jankae/electronicload/hardware/mechanical/frontpanel.pdf

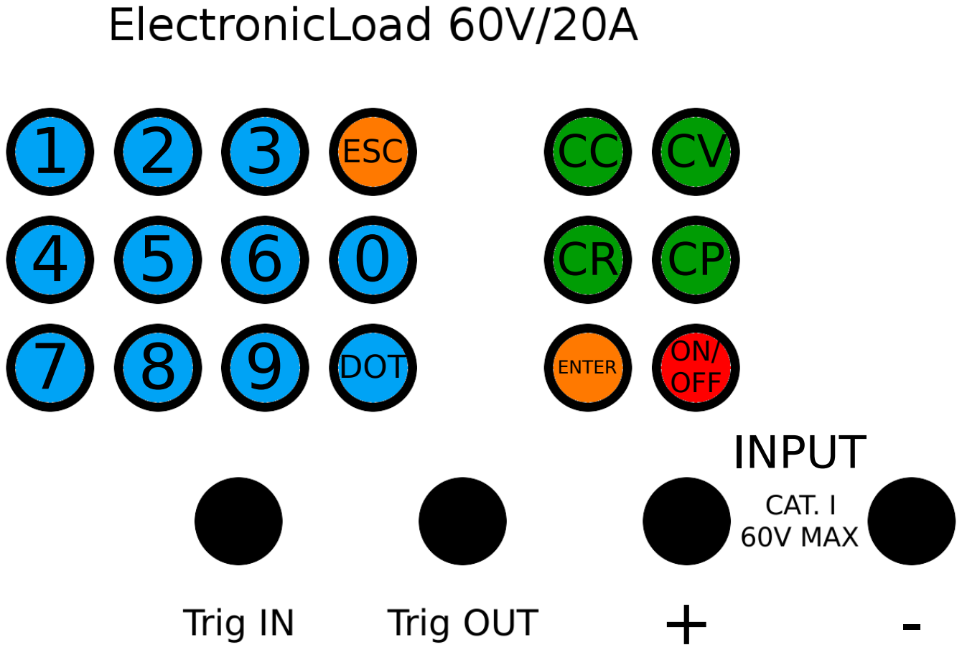
[picture p1: page 1]

ESC

DOT

1 2

ENTER
INPUT

+ -

3
4 5 6
7 8 9

0

CC

ON/
OFF

CV

CR CP
