jankae/electronicload/hardware/pcb/BOM.ods

Value | Description | Link | Price | PowerSupply | AnalogBoard | DigitalBoard | Sum | Available
Pinheader |  | Stiftleiste 1x36 pol gerade | 0.14 € | 4 | 16 | 21 | 41 | 0 | 0.28 €
1000µF/35V | 5mm Grid | RAD FC 1.000/35 (http://www.reichelt.de/Elkos-radial-105-C-1000-5000h/RAD-FC-1-000-35/3/index.html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) | 0.54 € | 2 |  |  | 2 | 0 | 1.08 €
100nF/0603 |  | X7R-G0603 100N (http://www.reichelt.de/Vielschicht-SMD-G0603/X7R-G0603-100N/3/index.html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) | 0.04 € | 6 | 8 | 20 | 34 | 80 | 0
10nF/Y2 | 15mm Grid | MP3-Y2 10N (http://www.reichelt.de/Funkentstoerkondensatoren/MP3-Y2-10N/3/index.html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) | 0.36 € | 2 |  |  | 2 | 0 | 0.72 €
220nF/X2 | 22mm Grid | FUNK 220N (http://www.reichelt.de/Funkentstoerkondensatoren/FUNK-220N/3/index.html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) | 0.21 € | 1 |  |  | 1 | 0 | 0.21 €
2x18V/5VA | Transformer EI42-2 | EI 42/14,8 218 (http://www.reichelt.de/Printtrafos-5-0-8-0VA/EI-42-14-8-218/3/index.html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) | 4.25 € | 1 |  |  | 1 | 0 | 4.25 €
312mA | Fuse+Holder, 22,5mm Grid | PL 112000 (http://www.reichelt.de/Sicherungshalter/PL-112000/3/index.html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) | 0.16 € | 1 |  |  | 1 | 0 | 0.16 €
470µ/16V | 5mm Grid | RAD FC 470/16 (http://www.reichelt.de/Elkos-radial-105-C-1000-5000h/RAD-FC-470-16/3/index.html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) | 0.23 € | 1 |  |  | 1 | 0 | 0.23 €
470µ/35V | 5mm Grid | RAD FC 470/35 (http://www.reichelt.de/Elkos-radial-105-C-1000-5000h/RAD-FC-470-35/3/index.html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) | 0.29 € | 2 |  |  | 2 | 0 | 0.58 €
LM7805 |  | µA 7805 (http://www.reichelt.de/-A-7805/3/index.html?&ACTION=3&LA=446&ARTICLE=23443&artnr=µA+7805&SEARCH=7805) | 0.27 € | 1 |  |  | 1 | 5 | 0
LM7815 |  | µA 7815 (http://www.reichelt.de/-A-7815/3/index.html?&ACTION=3&LA=446&ARTICLE=23458&artnr=µA+7815&SEARCH=7815) | 0.28 € | 1 |  |  | 1 | 0 | 0.28 €
LM7915 |  | µA 7915 (http://www.reichelt.de/-A-7915/3/index.html?&ACTION=3&LA=446&ARTICLE=23496&artnr=µA+7915&SEARCH=7915) | 0.31 € | 1 |  |  | 1 | 0 | 0.31 €
Rectifier | B-Dil | B40C800DIP (http://www.reichelt.de/Gleichrichter/B40C800DIP/3/index.html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) | 0.18 € | 1 |  |  | 1 | 0 | 0.18 €
0R/1206 |  | 1206 SMD 0 Ohm | 0.01 € |  | 1 |  | 1 | 0 | 0.01 €
0R1/5W | 6.4x25mm | 5W AXIAL 0,1 (http://www.reichelt.de/5-Watt-axial/5W-AXIAL-0-1/3/index.html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) | 0.36 € |  | 4 |  | 4 | 0 | 1.44 €
100R/0603 |  |  |  |  | 15 |  | 15 | 50 | 0
100µF/25V | 6mm, 2.5mm Grid | RAD FC 100/25 (http://www.reichelt.de/Elkos-radial-105-C-1000-5000h/RAD-FC-100-25/3/index.html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) | 0.12 € |  | 3 | 2 | 5 | 0 | 0.60 €
10kR/0603 |  |  |  |  | 3 | 2 | 5 | 50 | 0
18kR/0603 |  | 0603 SMD 18k Ohm | 0.01 € |  | 3 |  | 3 | 0 | 0.03 €
1MR/0603 |  | 0603 SMD 1 MOhm | 0.01 € |  | 1 | 1 | 2 | 0 | 0.02 €
1kR/0603 |  |  |  |  |  | 6 | 6 | 30 | 0
1k3R/0603 |  | 0603 SMD 1300 Ohm | 0.01 € |  | 1 |  | 1 | 0 | 0.01 €
22R/0603 |  | 0603 SMD 22 Ohm | 0.01 € |  | 4 | 1 | 5 | 0 | 0.05 €
24kR/0603 |  | 0603 SMD 24k Ohm | 0.01 € |  | 1 |  | 1 | 0 | 0.01 €
2kR/0603 |  | 0603 SMD 2000 Ohm | 0.01 € |  | 3 |  | 3 | 0 | 0.03 €
9k1R/0603 |  | 0603 SMD 9100 Ohm | 0.01 € |  | 1 |  | 1 | 0 | 0.01 €
BSS138 |  | BSS 138SMD (http://www.reichelt.de/BSS-138-SMD/3/index.html?ACTION=3&LA=446&ARTICLE=41437&artnr=BSS+138+SMD&SEARCH=bss138) | 0.04 € |  | 3 |  | 3 | 0 | 0.12 €
DAC7611 |  | DAC 7611U (http://www.reichelt.de/DAC-7611-U/3/index.html?ACTION=3&LA=446&ARTICLE=147248&artnr=DAC+7611+U&SEARCH=dac7611) | 4.30 € |  | 1 |  | 1 | 0 | 4.30 €
INA138 |  | INA138 | 2.49 € |  | 1 |  | 1 | 0 | 2.49 €
IRFP250 |  | IRFP 250N (http://www.reichelt.de/IRFP-250N/3/index.html?ACTION=3&LA=446&ARTICLE=41678&artnr=IRFP+250N&SEARCH=irfp250) | 1.15 € |  | 4 |  | 4 | 0 | 4.60 €
LM35DT |  | LM 35 DT (http://www.reichelt.de/LM-35-DT/3/index.html?ACTION=3&LA=446&ARTICLE=109401&artnr=LM+35+DT&SEARCH=lm35dt) | 1.90 € |  | 2 |  | 2 | 0 | 3.80 €
SHUNT | 2mm Copperwire |  |  |  | 1 |  | 1 | 0 | 0
TL074D |  | TL 074 CD SMD (http://www.reichelt.de/TL-074-CD-SMD/3/index.html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) | 0.32 € |  | 2 |  | 2 | 0 | 0.64 €
TVS-82V | TVS-Diode, CB429-15 | 1,5KE 82A (http://www.reichelt.de/Ueberspannungs-schutzdioden/1-5KE-82A/3/index.html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) | 0.11 € |  | 1 |  | 1 | 0 | 0.11 €
ZD4V7 | Z-Diode, SOT23 | SMD ZD 4,7 (http://www.reichelt.de/SMD-Z-Dioden-SOT23/SMD-ZD-4-7/3/index.html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) | 0.04 € |  | 2 |  | 2 | 0 | 0.08 €
SMD-Switch |  | TASTER 9320 (http://www.reichelt.de/Kurzhubtaster/TASTER-9320/3/index.html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) | 0.21 € |  |  | 18 | 18 | 0 | 3.78 €
LM1117-3.3 |  | TS 1117 BCW33 (http://www.reichelt.de/TS-1117-BCW33/3/index.html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) | 0.30 € |  |  | 1 | 1 | 0 | 0.30 €
ML20 | 20-Pin Connector | Wannenstecker 20 pol ger. | 0.13 € |  |  | 1 | 1 | 0 | 0.13 €
10µH/0805 |  | Indukt. 0805 10µH | 0.24 € |  |  | 1 | 1 | 0 | 0.24 €
16MHz | Crystal, CTS406 | 16,000000-MJ (http://www.reichelt.de/Quarze-SMD-Keramikgehaeuse/16-000000-MJ/3/index.html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) | 0.95 € |  |  | 1 | 1 | 0 | 0.95 €
12pF/0603 |  | 0603 KerKo 12pF | 0.01 € |  |  | 2 | 2 | 0 | 0.02 €
74HC4050D |  | SMD HC 4050 (http://www.reichelt.de/SMD-HC-4050/3/index.html?ACTION=3&LA=446&ARTICLE=18686&artnr=SMD+HC+4050&SEARCH=hc4050) | 0.26 € |  |  | 1 | 1 | 0 | 0.26 €
1N4148 | SOD323 | 1N 4148WS (http://www.reichelt.de/1N-4148-WS/3/index.html?ACTION=3&LA=446&ARTICLE=95197&artnr=1N+4148+WS&SEARCH=1n4148) | 0.04 € |  |  | 18 | 18 | 0 | 0.72 €
5kR | Trimmer | 64W-5,0K (http://www.reichelt.de/Praezisionstrimmer/64W-5-0K/3/index.html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) | 0.32 € |  |  | 1 | 1 | 0 | 0.32 €
1kR | Trimmer | 64W-1,0K (http://www.reichelt.de/Praezisionstrimmer/64W-1-0K/3/index.html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) | 0.32 € |  |  | 1 | 1 | 0 | 0.32 €
74HCT245DW |  | 74VHCT 245 D (http://www.reichelt.de/74VHCT-245-D/3/index.html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) | 0.36 € |  |  | 2 | 2 | 0 | 0.72 €
Encoder+Switch |  |  |  |  |  | 1 | 1 | 1 | 0
IRLML2502 |  | IRLML 2502 (http://www.reichelt.de/IRLML-2502/3/index.html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) | 0.19 € |  |  | 2 | 2 | 0 | 0.38 €
MAX3232CSE |  | MAX 3232CSE (http://www.reichelt.de/MAX-3232-CSE/3/index.html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) | 1.20 € |  |  | 1 | 1 | 0 | 1.20 €
STM32F103RBT6 |  | STM32 F103RBT6 (http://www.reichelt.de/STM32-F103RBT6/3/index.html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) | 4.70 € |  |  | 1 | 1 | 0 | 4.70 €
Display |  | LCD-Modul TG12864B-03 (http://www.pollin.de/shop/dt/NTc1OTc4OTk-/Bauelemente_Bauteile/Aktive_Bauelemente/Displays/LCD_Modul_TG12864B_03.html) | 19.95 € |  |  | 1 | 1 | 0 | 19.95 €
Heatsink1 |  | SK 574 50 (http://www.reichelt.de/Leistungs-Kuehlkoerper/SK-574-50/3/index.html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) | 1.75 € | 1 |  |  | 1 | 0 | 1.75 €
Heatsink2 |  | V 7331G (http://www.reichelt.de/Profilkuehlkoerper/V-7331G/3/index.html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) | 5.99 € |  | 2 |  | 2 | 0 | 11.98 €
GlimmerTO247 |  | GLIMMER SOT 93 (http://www.reichelt.de/Waermeleit-paste-folien-scheiben/GLIMMER-SOT-93/3/index.html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) | 0.05 € |  | 4 |  | 4 | 0 | 0.20 €
GlimmerTO220 |  | GLIMMER TO 220 (http://www.reichelt.de/Waermeleit-paste-folien-scheiben/GLIMMER-TO-220/3/index.html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) | 0.04 € | 3 |  |  | 3 | 0 | 0.12 €
Fan |  | FAN-ML 4010-12 P (http://www.reichelt.de/Luefter/FAN-ML-4010-12-P/3/index.html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) | 1.99 € |  | 2 |  | 2 | 0 | 3.98 €
BNC |  | UG 1094U (http://www.reichelt.de/UG-1094U/3/index.html?ACTION=3&LA=446&ARTICLE=22014&artnr=UG+1094U&SEARCH=bnc) | 0.36 € |  |  | 2 | 2 | 0 | 0.72 €
SUBD |  |  |  |  |  | 1 | 1 | 6 | 0
Polklemme/red |  | PK 4 RT (http://www.reichelt.de/PK-4-RT/3/index.html?ACTION=3&LA=446&ARTICLE=14662&artnr=PK+4+RT&SEARCH=polklemme) | 0.71 € |  | 1 |  | 1 | 0 | 0.71 €
Polklemme/black |  | PK 4 SW (http://www.reichelt.de/PK-4-SW/3/index.html?ACTION=3&LA=446&ARTICLE=14663&artnr=PK+4+SW&SEARCH=polklemme) | 0.71 € |  | 1 |  | 1 | 0 | 0.71 €
 |  |  |  |  |  |  |  |  | 80.79 €
