jankae/electronicload/hardware/pcb/analogControlBoardV1_3.brd

## EAGLE design hardware/pcb/analogControlBoardV1_3.brd (2017-04-25)

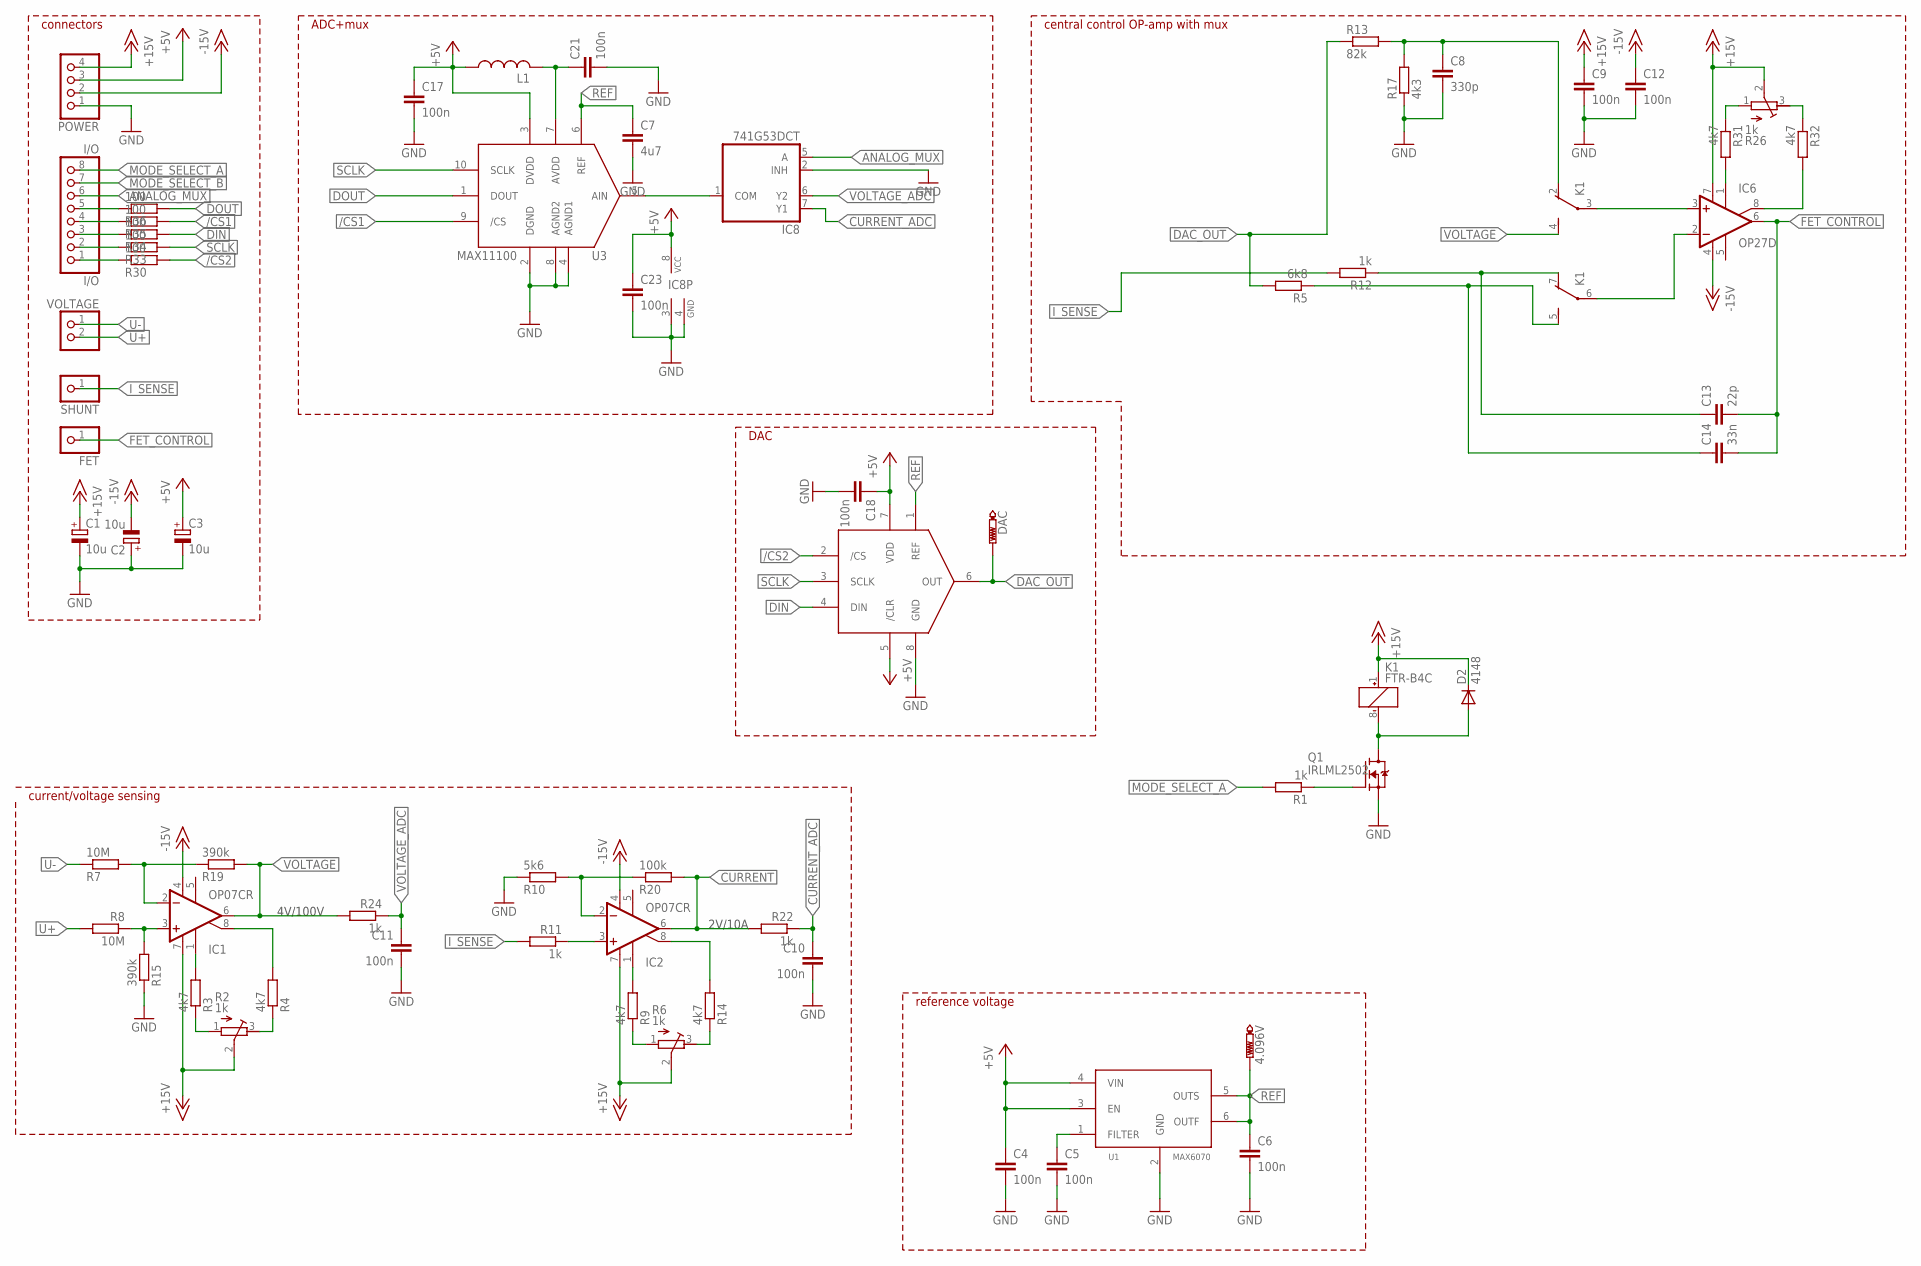
[picture p2: schematic analogControlBoardV1_3.sch]

Parts:
4.096V: PTR1TP14R; TP14R
C1, C2, C3: 10u; 153CLV-0505
C4, C5, C6, C9, C10, C11, C12, C17, C18, C21, C23: 100n; C0603K
C7: 4u7; C0805
C8: 330p; C0603K
C13: 22p; C0603K
C14: 33n; C0603K
D2: 4148; SOD123
DAC: PTR1TP14R; TP14R
FET: PINHD-1X1; 1X01
I/O: I/O; 1X08
IC1, IC2: OP07CR; SO08
IC6: OP27D; SO08
IC8: 741G53DCT; DCT_R-PDSO-G8
K1: FTR-B4C
L1: INDUCTOR0603; R0603
POWER: PINHD-1X4; 1X04
Q1: IRLML2502; SOT23-3
R1, R11, R12, R22, R24: 1k; R0603
R2, R6, R26: 1k; RTRIM64W
R3, R4, R9, R14, R31, R32: 4k7; R0603
R5: 6k8; R0603
R7, R8: 10M; R0603
R10: 5k6; R0603
R13: 82k; R0603
R15, R19: 390k; R0603
R17: 4k3; R0603
R20: 100k; R0603
R30, R33, R34, R35, R36: 100; R0603
SHUNT: PINHD-1X1; 1X01
U1: MAX6070; SOT23-6L
U2: MAX5216; UMAX8
U3: MAX11100; UMAX10
VOLTAGE: PINHD-1X2; 1X02

Connections:
+5V: C3.+, C4.1, C17.1, C18.1, C23.1, IC8.8 (VCC), L1.1, POWER.3, U1.3 (EN), U1.4 (VIN), U2.5 (/CLR), U2.7 (VDD), U3.3 (DVDD)
+15V: C1.+, C9.1, D2.C, IC1.7 (V+), IC2.7 (V+), IC6.7 (V+), K1.1 (+), POWER.4, R2.2 (S), R6.2 (S), R26.2 (S)
-15V: C2.-, C12.1, IC1.4 (V-), IC2.4 (V-), IC6.4 (V-), POWER.2
/CS1: R35.2, U3.9 (/CS)
/CS2: R30.2, U2.2 (/CS)
ANALOG_MUX: I/O.6, IC8.5 (A)
CURRENT: IC2.6 (OUT), R20.2, R22.2
CURRENT_ADC: C10.1, IC8.7 (Y1), R22.1
DAC_OUT: DAC.TP, R5.2, R13.1, U2.6 (OUT)
DIN: R34.2, U2.4 (DIN)
DOUT: R36.2, U3.1 (DOUT)
FET_CONTROL: C13.2, C14.2, FET.1, IC6.6 (OUT)
GND: C1.-, C2.+, C3.-, C4.2, C5.2, C6.2, C7.2, C8.2, C9.2, C10.2, C11.2, C12.2, C17.2, C18.2, C21.2, C23.2, IC8.2 (INH), IC8.3 (GND), IC8.4 (GND), POWER.1, Q1.2 (S), R10.1, R15.1, R17.1, U1.2 (GND), U2.8 (GND), U3.2 (DGND), U3.4 (AGND1), U3.8 (AGND2)
I_SENSE: R11.2, R12.2, SHUNT.1
MODE_SELECT_A: I/O.8, R1.2
MODE_SELECT_B: I/O.7
unnamed: C8.1, K1.2 (O), R13.2, R17.2
unnamed: D2.A, K1.8 (-), Q1.3 (D)
unnamed: Q1.1 (G), R1.1
unnamed: C13.1, K1.7 (O), R12.1
unnamed: IC2.3 (+IN), R11.1
unnamed: IC2.2 (-IN), R10.2, R20.1
unnamed: R2.1 (E), R3.1
unnamed: IC1.8 (ON2), R4.2
unnamed: R26.3 (A), R32.1
unnamed: R2.3 (A), R4.1
unnamed: IC6.1 (ON1), R31.2
unnamed: IC1.1 (ON1), R3.2
unnamed: R6.1 (E), R9.1
unnamed: IC2.8 (ON2), R14.2
unnamed: R6.3 (A), R14.1
unnamed: IC2.1 (ON1), R9.2
unnamed: I/O.5, R36.1
unnamed: I/O.4, R35.1
unnamed: I/O.3, R34.1
unnamed: I/O.2, R33.1
unnamed: I/O.1, R30.1
unnamed: IC6.3 (+IN), K1.3
unnamed: C5.1, U1.1 (FILTER)
unnamed: IC6.2 (-IN), K1.6
unnamed: C14.1, K1.5 (S), R5.1
unnamed: R26.1 (E), R31.1
unnamed: IC6.8 (ON2), R32.2
unnamed: C21.1, L1.2, U3.7 (AVDD)
unnamed: IC8.1 (COM), U3.5 (AIN)
unnamed: IC1.3 (+IN), R8.1, R15.2
unnamed: IC1.2 (-IN), R7.2, R19.1
REF: 4.096V.TP, C6.1, C7.1, U1.5 (OUTS), U1.6 (OUTF), U2.1 (REF), U3.6 (REF)
SCLK: R33.2, U2.3 (SCLK), U3.10 (SCLK)
U+: R8.2, VOLTAGE.2
U-: R7.1, VOLTAGE.1
VOLTAGE: IC1.6 (OUT), K1.4 (S), R19.2, R24.2
VOLTAGE_ADC: C11.1, IC8.6 (Y2), R24.1

Notes on the sheet:
2V/10A
4V/100V
connectors
ADC+mux
DAC
current/voltage sensing
reference voltage
central control OP-amp with mux

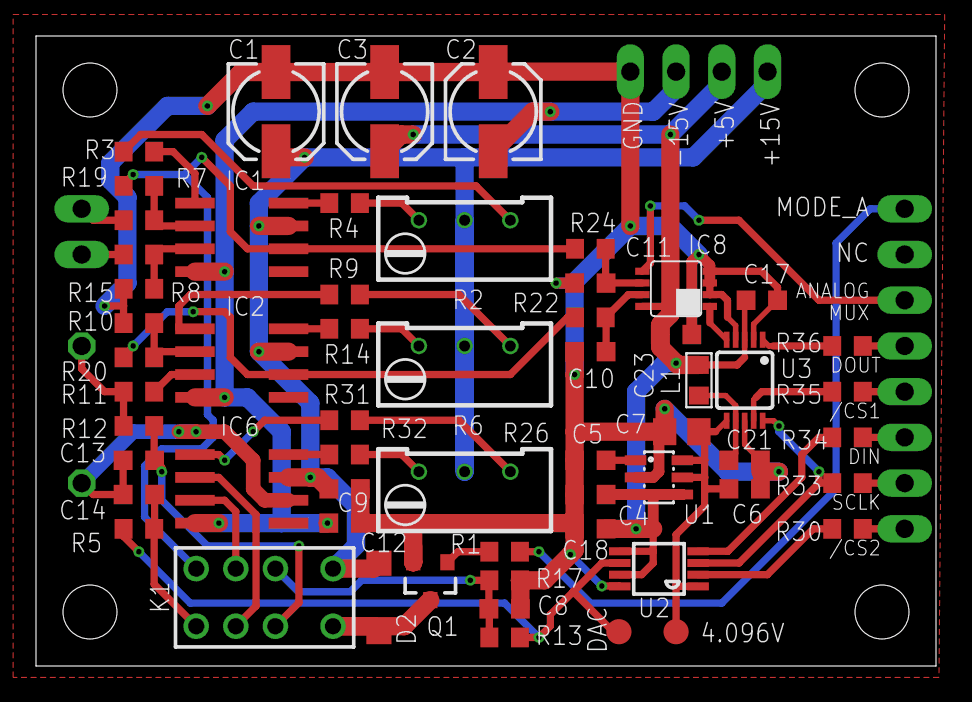
[picture p3: board analogControlBoardV1_3.brd from above]

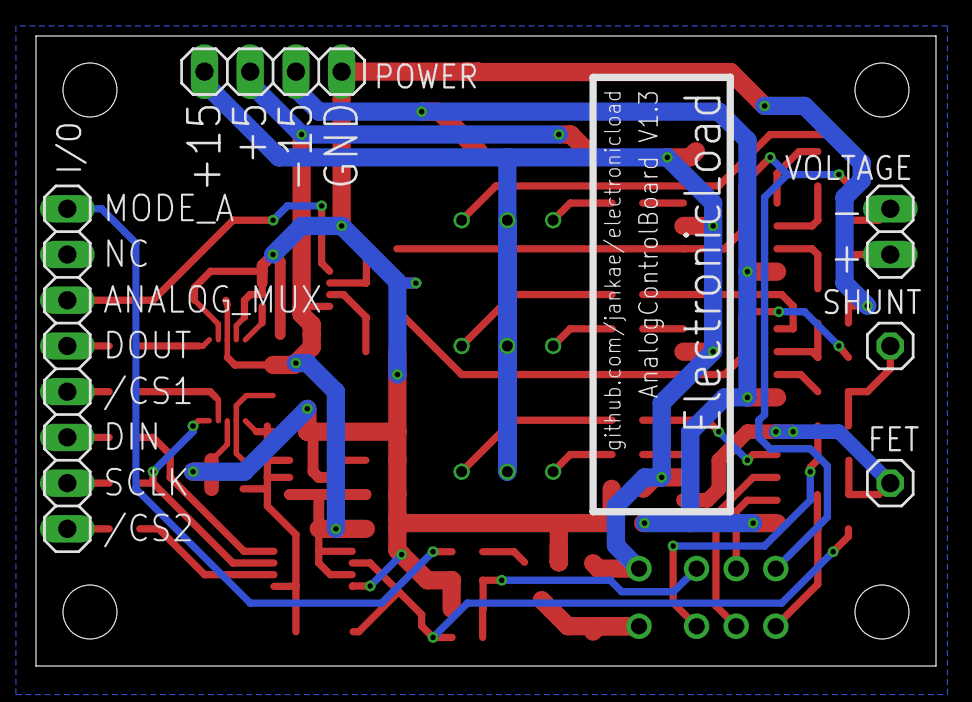
[picture p4: board analogControlBoardV1_3.brd from below]

Board: 2 copper layers, 50.0 x 35.0 mm, 64 parts (5 on the bottom side), 52 nets.
