jankae/electronicload/hardware/pcb/analogBoardV1_5.brd

## EAGLE design hardware/pcb/analogBoardV1_5.brd (2016-09-09)

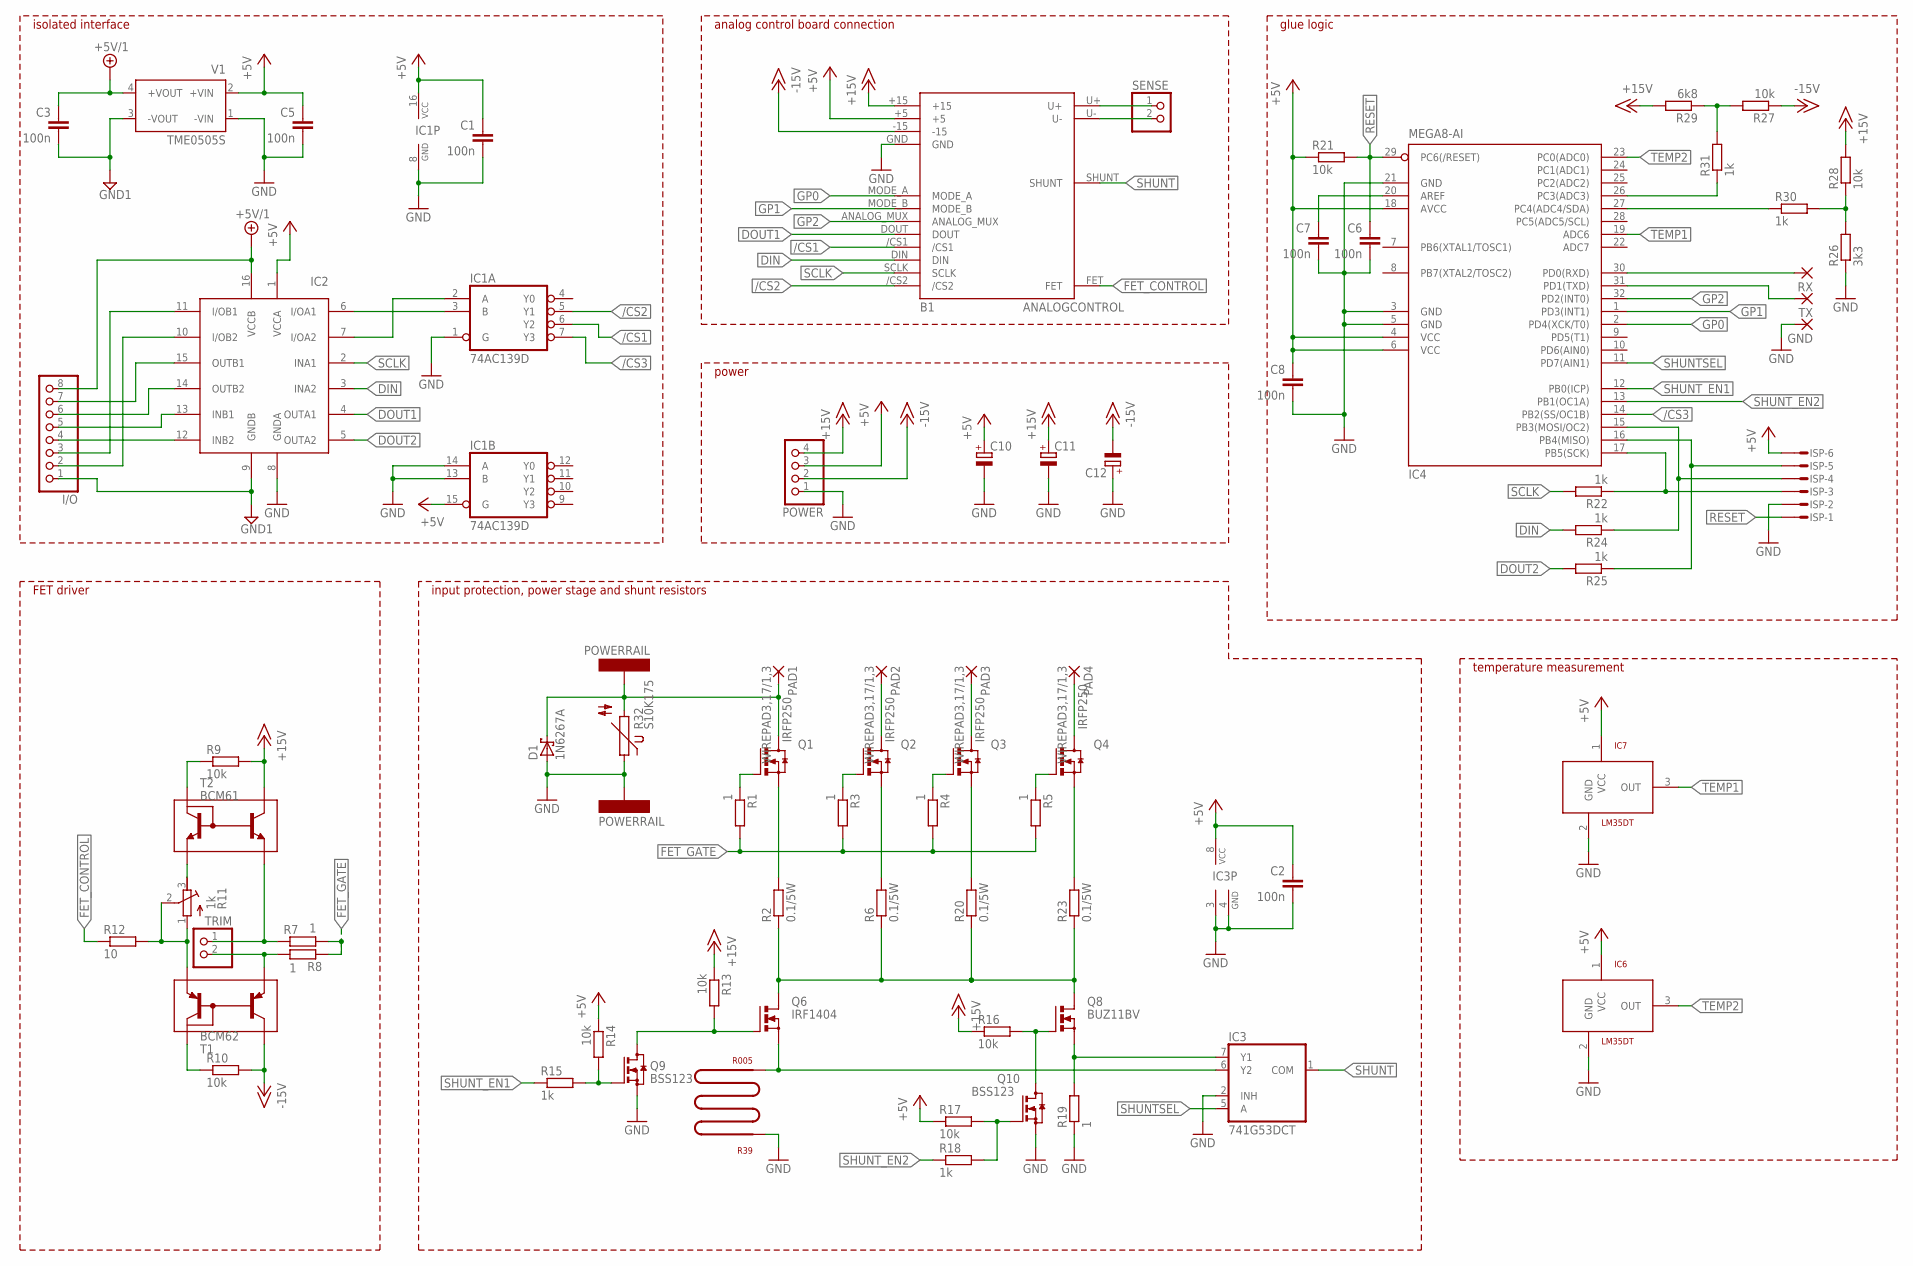
[picture p5: schematic analogBoardV1_5.sch]

Parts:
B1: ANALOGCONTROL
C1, C2, C3, C5, C6, C7, C8: 100n; C0603K
C10, C11, C12: CPOL-EUE2.5-6; E2,5-6
D1: 1N6267A; C4111-15
GND: SMD2; SMD1,27-2,54
I/O: PINHD-1X8; 1X08
IC1: 74AC139D; SO16
IC2: MAX14850; SOIC16N
IC3: 741G53DCT; DCT_R-PDSO-G8
IC4: MEGA8-AI; TQFP32-08
IC6, IC7: LM35DT; TO220V
ISP: MICROMATCH-6SMF; MMT-F-SMD-6
PAD1, PAD2, PAD3, PAD4: WIREPAD3,17/1,3; 3,17/1,3
POWER: PINHD-1X4; 1X04
Q1, Q2, Q3, Q4: IRFP250; TO-247AD-V
Q6: IRF1404; TO220BV
Q8: BUZ11BV; TO220BV
Q9, Q10: BSS123; SOT23
R1, R3, R4, R5, R7, R8: 1; R0603
R2, R6, R20, R23: 0.1/5W; 5WAXIAL_H
R9, R10, R13, R14, R16, R17, R21, R27, R28: 10k; R0603
R11: 1k; RTRIM64W
R12: 10; R0603
R15, R18, R22, R24, R25, R30, R31: 1k; R0603
R19: 1; 0414/15
R26: 3k3; R0603
R29: 6k8; R0603
R32: S10K175
R39: R005; PWR4412-2S
RX: SMD2; SMD1,27-2,54
SENSE: PINHD-1X2; 1X02
T1: BCM62; SOT143B
T2: BCM61; SOT143B
TRIM: PINHD-1X2; 1X02
TX: SMD2; SMD1,27-2,54
U$1, U$2: POWERRAIL
V1: TME0505S; TME

Connections:
+5V: B1.+5, C1.1, C2.1, C5.1, C8.1, C10.+, IC1.15 (G), IC1.16 (VCC), IC2.1 (VCCA), IC3.8 (VCC), IC4.4 (VCC), IC4.6 (VCC), IC4.18 (AVCC), IC6.1 (VCC), IC7.1 (VCC), ISP.6, POWER.3, R14.1, R17.1, R21.1, V1.2 (+VIN)
+5V/1: C3.1, I/O.8, IC2.16 (VCCB), V1.4 (+VOUT)
+15V: B1.+15, C11.+, POWER.4, R9.2, R13.1, R16.1, R28.2, R29.2, T2.2
-15V: B1.-15, C12.-, POWER.2, R10.2, R27.1, T1.2
/CS1: B1./CS1, IC1.6 (Y2)
/CS2: B1./CS2, IC1.5 (Y1)
/CS3: IC1.7 (Y3), IC4.14 (PB2(SS/OC1B))
DIN: B1.DIN, IC2.3 (INA2), R24.2
DOUT1: B1.DOUT, IC2.4 (OUTA1)
DOUT2: IC2.5 (OUTA2), R25.2
FET_CONTROL: B1.FET, R12.1
FET_GATE: R1.2, R3.2, R4.2, R5.2, R7.2, R8.1
GND: B1.GND, C1.2, C2.2, C5.2, C6.2, C7.2, C8.2, C10.-, C11.-, C12.+, D1.A, GND.1, IC1.1 (G), IC1.8 (GND), IC1.13 (B), IC1.14 (A), IC2.8 (GNDA), IC3.2 (INH), IC3.3 (GND), IC3.4 (GND), IC4.3 (GND), IC4.5 (GND), IC4.21 (GND), IC6.2 (GND), IC7.2 (GND), ISP.2, POWER.1, Q9.2 (S), Q10.2 (S), R19.1, R26.1, R32.1, R39.P$1, U$2.1, V1.1 (-VIN)
GND1: C3.2, I/O.1, IC2.9 (GNDB), V1.3 (-VOUT)
GP0: B1.MODE_A, IC4.2 (PD4(XCK/T0))
GP1: B1.MODE_B, IC4.1 (PD3(INT1))
GP2: B1.ANALOG_MUX, IC4.32 (PD2(INT0))
N: Q6.D, Q8.D, R2.1, R6.1, R20.1, R23.1
unnamed: R9.1, T2.1
unnamed: Q1.G, R1.1
unnamed: Q1.S, R2.2
unnamed: Q4.G, R5.1
unnamed: Q3.G, R4.1
unnamed: Q2.G, R3.1
unnamed: I/O.4, IC2.12 (INB2)
unnamed: Q2.S, R6.2
unnamed: R7.1, T2.3, TRIM.1
unnamed: R8.2, T1.3, TRIM.2
unnamed: R10.1, T1.1
unnamed: I/O.5, IC2.13 (INB1)
unnamed: R11.3 (A), T2.4
unnamed: I/O.6, IC2.14 (OUTB2)
unnamed: I/O.7, IC2.15 (OUTB1)
unnamed: B1.U+, SENSE.1
unnamed: Q6.G, Q9.3 (D), R13.2
unnamed: Q3.S, R20.2
unnamed: R11.1 (E), R11.2 (S), R12.2, T1.4
unnamed: IC1.3 (B), IC2.6 (I/OA1)
unnamed: Q9.1 (G), R14.2, R15.2
unnamed: Q8.G, Q10.3 (D), R16.2
unnamed: Q10.1 (G), R17.2, R18.2
unnamed: PAD2.1, Q2.D
unnamed: IC1.2 (A), IC2.7 (I/OA2)
unnamed: Q4.S, R23.2
unnamed: I/O.3, IC2.11 (I/OB1)
unnamed: I/O.2, IC2.10 (I/OB2)
unnamed: PAD3.1, Q3.D
unnamed: C7.1, IC4.20 (AREF)
unnamed: IC4.30 (PD0(RXD)), RX.1
unnamed: IC4.31 (PD1(TXD)), TX.1
unnamed: R26.2, R28.1, R30.2
unnamed: R27.2, R29.1, R31.2
unnamed: IC4.27 (PC4(ADC4/SDA)), R30.1
unnamed: IC4.26 (PC3(ADC3)), R31.1
unnamed: B1.U-, SENSE.2
unnamed: IC4.15 (PB3(MOSI/OC2)), ISP.4, R24.1
unnamed: IC4.17 (PB5(SCK)), ISP.3, R22.1
unnamed: IC4.16 (PB4(MISO)), ISP.5, R25.1
POS_INPUT1: PAD4.1, Q4.D
RESET: C6.1, IC4.29 (PC6(/RESET)), ISP.1, R21.2
SCLK: B1.SCLK, IC2.2 (INA1), R22.2
SHUNT: B1.SHUNT, IC3.1 (COM)
SHUNT1: IC3.6 (Y2), Q6.S, R39.P$2
SHUNT2: IC3.7 (Y1), Q8.S, R19.2
SHUNTSEL: IC3.5 (A), IC4.11 (PD7(AIN1))
SHUNT_EN1: IC4.12 (PB0(ICP)), R15.1
SHUNT_EN2: IC4.13 (PB1(OC1A)), R18.1
TEMP1: IC4.19 (ADC6), IC7.3 (OUT)
TEMP2: IC4.23 (PC0(ADC0)), IC6.3 (OUT)
VIN: D1.C, PAD1.1, Q1.D, R32.2, U$1.1

Notes on the sheet:
FET driver
input protection, power stage and shunt resistors
temperature measurement
power
analog control board connection
glue logic
isolated interface

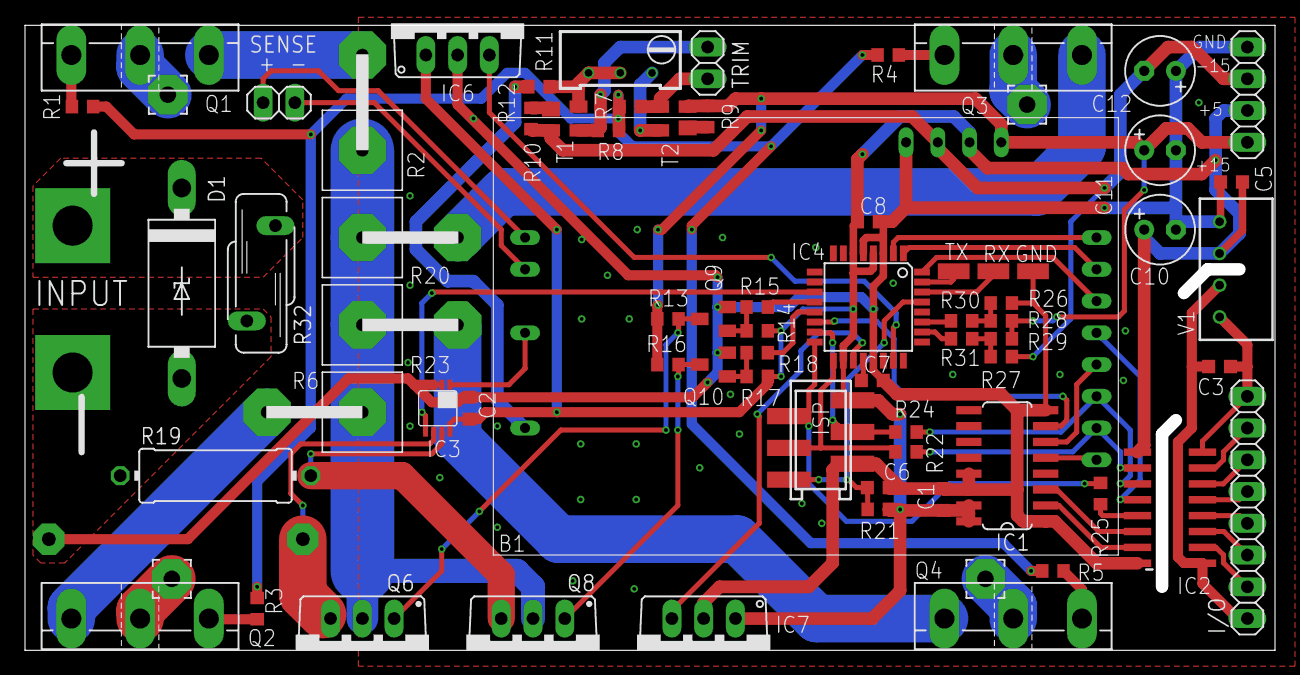
[picture p6: board analogBoardV1_5.brd from above]

Board: 2 copper layers, 100.0 x 50.0 mm, 76 parts (0 on the bottom side), 70 nets.
