jankae/electronicload/hardware/pcb/analogControlBoardV1.brd

## EAGLE design hardware/pcb/analogControlBoardV1.brd (2016-09-09, an earlier design)

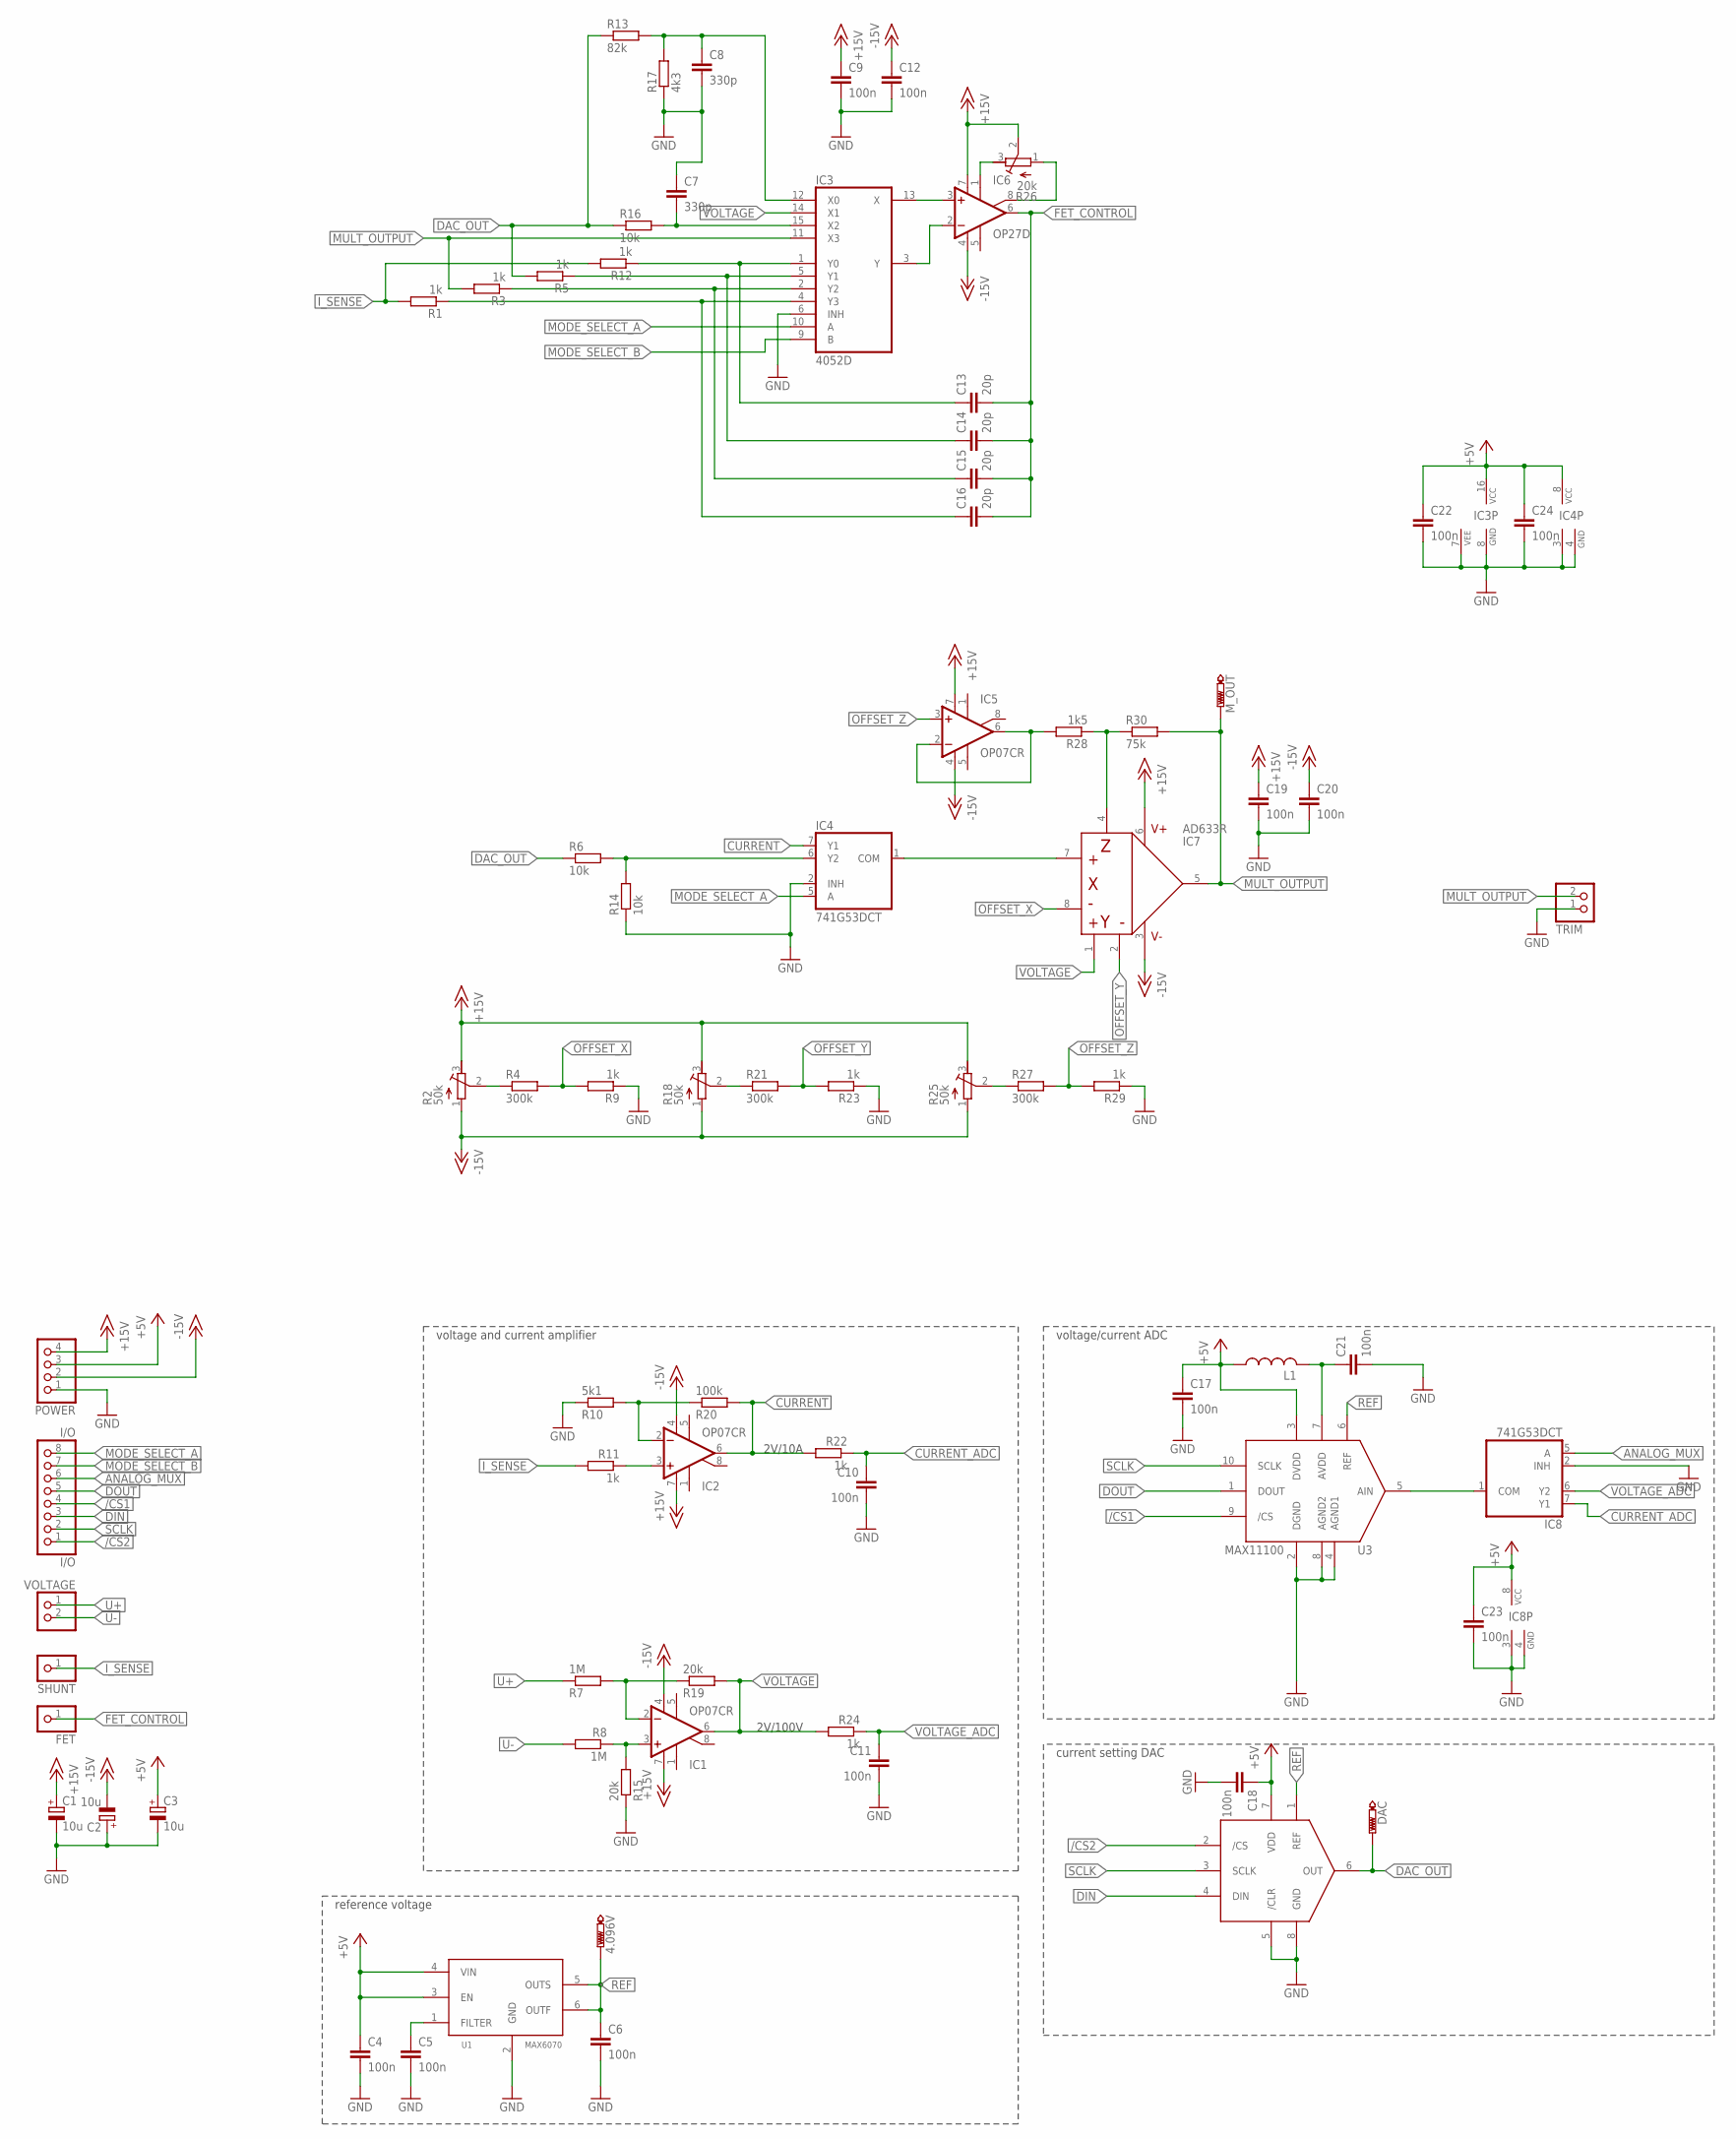
[picture p7: schematic analogControlBoardV1.sch]

Parts:
4.096V: PTR1TP06R; TP06R
C1, C2, C3: 10u; 153CLV-0505
C4, C5, C6, C9, C10, C11, C12, C17, C18, C19, C20, C21, C22, C23, C24: 100n; C0603K
C7, C8: 330p; C0603K
C13, C14, C15, C16: 20p; C0603K
DAC: PTR1TP06R; TP06R
FET: PINHD-1X1; 1X01
I/O: I/O; 1X08
IC1, IC2, IC5: OP07CR; SO08
IC3: 4052D; SO16
IC4, IC8: 741G53DCT; DCT_R-PDSO-G8
IC6: OP27D; SO08
IC7: AD633R; SO08
L1: INDUCTOR0603; R0603
M_OUT: PTR1TP06R; TP06R
POWER: PINHD-1X4; 1X04
R1, R3, R5, R9, R11, R12, R22, R23, R24, R29: 1k; R0603
R2, R18, R25: 50k; RTRIM64W
R4, R21, R27: 300k; R0603
R6, R14, R16: 10k; R0603
R7, R8: 1M; R0603
R10: 5k1; R0603
R13: 82k; R0603
R15, R19: 20k; R0603
R17: 4k3; R0603
R20: 100k; R0603
R26: 20k; RTRIM64W
R28: 1k5; R0603
R30: 75k; R0603
SHUNT: PINHD-1X1; 1X01
TRIM: PINHD-1X2; 1X02
U1: MAX6070; SOT23-6L
U2: MAX5216; UMAX8
U3: MAX11100; UMAX10
VOLTAGE: PINHD-1X2; 1X02

Connections:
+5V: C3.+, C4.1, C17.1, C18.1, C22.1, C23.1, C24.1, IC3.16 (VCC), IC4.8 (VCC), IC8.8 (VCC), L1.1, POWER.3, U1.3 (EN), U1.4 (VIN), U2.7 (VDD), U3.3 (DVDD)
+15V: C1.+, C9.1, C19.1, IC1.7 (V+), IC2.7 (V+), IC5.7 (V+), IC6.7 (V+), IC7.6 (V+), POWER.4, R2.3 (A), R18.3 (A), R25.3 (A), R26.2 (S)
-15V: C2.-, C12.1, C20.1, IC1.4 (V-), IC2.4 (V-), IC5.4 (V-), IC6.4 (V-), IC7.3 (V-), POWER.2, R2.1 (E), R18.1 (E), R25.1 (E)
/CS1: I/O.4, U3.9 (/CS)
/CS2: I/O.1, U2.2 (/CS)
ANALOG_MUX: I/O.6, IC8.5 (A)
CURRENT: IC2.6 (OUT), IC4.7 (Y1), R20.2, R22.2
CURRENT_ADC: C10.1, IC8.7 (Y1), R22.1
DAC_OUT: DAC.TP, R5.2, R6.1, R13.1, R16.1, U2.6 (OUT)
DIN: I/O.3, U2.4 (DIN)
DOUT: I/O.5, U3.1 (DOUT)
FET_CONTROL: C13.2, C14.2, C15.2, C16.2, FET.1, IC6.6 (OUT)
GND: C1.-, C2.+, C3.-, C4.2, C5.2, C6.2, C7.1, C8.2, C9.2, C10.2, C11.2, C12.2, C17.2, C18.2, C19.2, C20.2, C21.2, C22.2, C23.2, C24.2, IC3.6 (INH), IC3.7 (VEE), IC3.8 (GND), IC4.2 (INH), IC4.3 (GND), IC4.4 (GND), IC8.2 (INH), IC8.3 (GND), IC8.4 (GND), POWER.1, R9.1, R10.1, R14.1, R15.1, R17.1, R23.1, R29.1, TRIM.1, U1.2 (GND), U2.5 (/CLR), U2.8 (GND), U3.2 (DGND), U3.4 (AGND1), U3.8 (AGND2)
I_SENSE: R1.2, R11.2, R12.2, SHUNT.1
MODE_SELECT_A: I/O.8, IC3.10 (A), IC4.5 (A)
MODE_SELECT_B: I/O.7, IC3.9 (B)
MULT_OUTPUT: IC3.11 (X3), IC7.5 (OUT), M_OUT.TP, R3.2, R30.2, TRIM.2
unnamed: C8.1, IC3.12 (X0), R13.2, R17.2
unnamed: IC7.4 (Z), R28.1, R30.1
unnamed: IC4.6 (Y2), R6.2, R14.2
unnamed: C13.1, IC3.1 (Y0), R12.1
unnamed: IC2.3 (+IN), R11.1
unnamed: IC2.2 (-IN), R10.2, R20.1
unnamed: IC5.2 (-IN), IC5.6 (OUT), R28.2
unnamed: R25.2 (S), R27.1
unnamed: C7.2, IC3.15 (X2), R16.2
unnamed: IC3.13 (X), IC6.3 (+IN)
unnamed: C5.1, U1.1 (FILTER)
unnamed: IC3.3 (Y), IC6.2 (-IN)
unnamed: IC4.1 (COM), IC7.7 (X+)
unnamed: R18.2 (S), R21.1
unnamed: C16.1, IC3.4 (Y3), R1.1
unnamed: R2.2 (S), R4.1
unnamed: C15.1, IC3.2 (Y2), R3.1
unnamed: C14.1, IC3.5 (Y1), R5.1
unnamed: IC6.1 (ON1), R26.3 (A)
unnamed: IC6.8 (ON2), R26.1 (E)
unnamed: C21.1, L1.2, U3.7 (AVDD)
unnamed: IC8.1 (COM), U3.5 (AIN)
unnamed: IC1.3 (+IN), R8.1, R15.2
unnamed: IC1.2 (-IN), R7.2, R19.1
OFFSET_X: IC7.8 (X-), R4.2, R9.2
OFFSET_Y: IC7.2 (Y-), R21.2, R23.2
OFFSET_Z: IC5.3 (+IN), R27.2, R29.2
REF: 4.096V.TP, C6.1, U1.5 (OUTS), U1.6 (OUTF), U2.1 (REF), U3.6 (REF)
SCLK: I/O.2, U2.3 (SCLK), U3.10 (SCLK)
U+: R7.1, VOLTAGE.1
U-: R8.2, VOLTAGE.2
VOLTAGE: IC1.6 (OUT), IC3.14 (X1), IC7.1 (Y+), R19.2, R24.2
VOLTAGE_ADC: C11.1, IC8.6 (Y2), R24.1

Notes on the sheet:
2V/10A
2V/100V
reference voltage
voltage and current amplifier
voltage/current ADC
current setting DAC

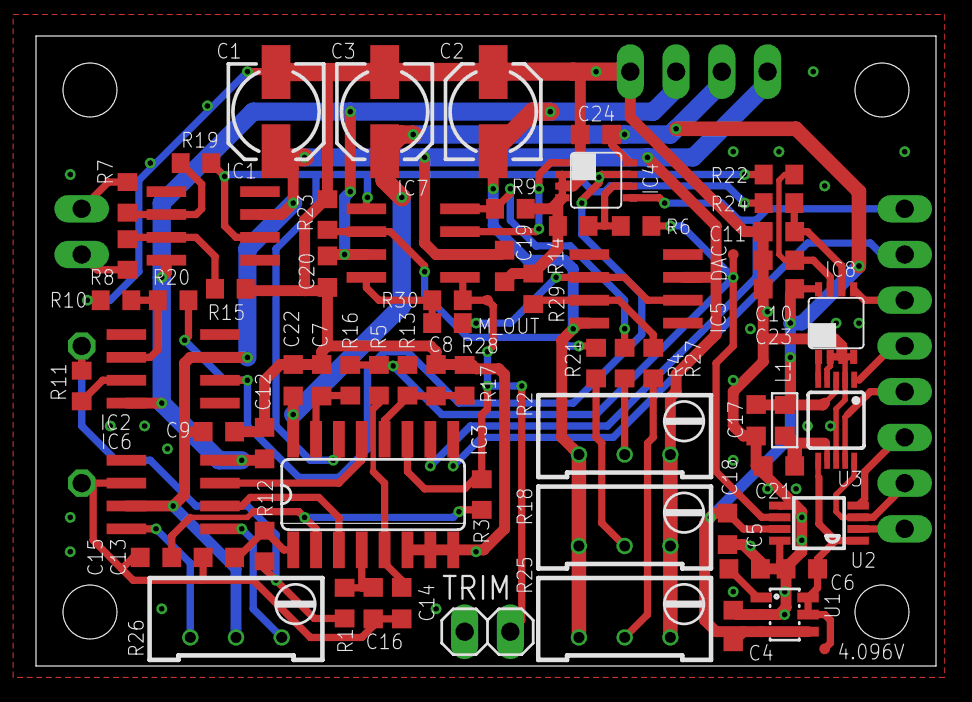
[picture p8: board analogControlBoardV1.brd from above]

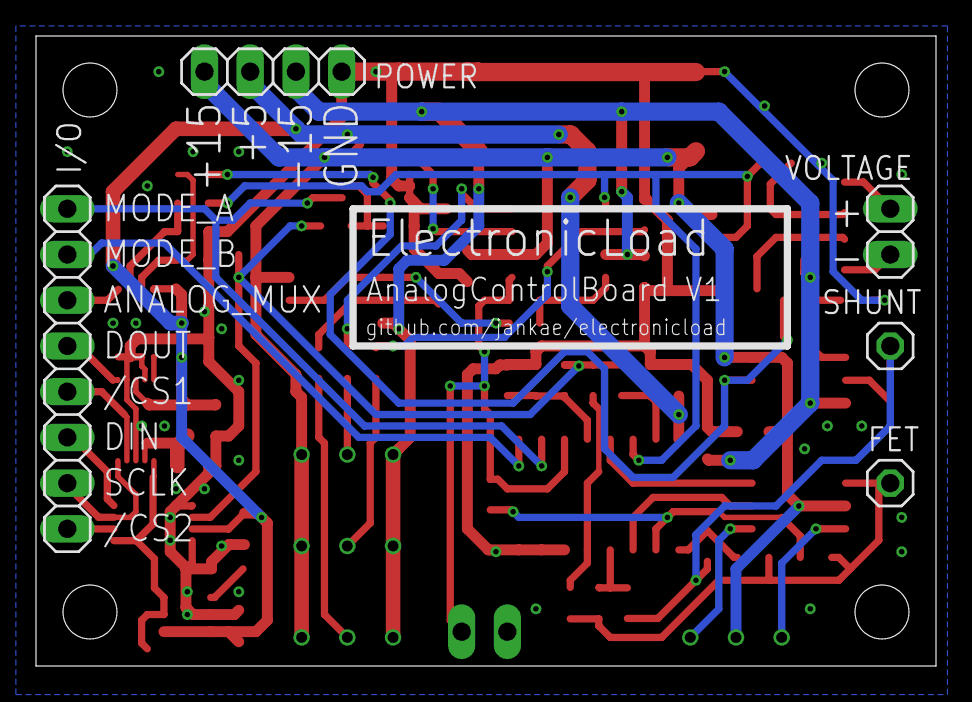
[picture p9: board analogControlBoardV1.brd from below]

Board: 2 copper layers, 50.0 x 35.0 mm, 75 parts (5 on the bottom side), 50 nets.
