jankae/electronicload/hardware/pcb/analogBoardV1_2.brd

## EAGLE design hardware/pcb/analogBoardV1_2.brd (2016-03-21, an earlier design)

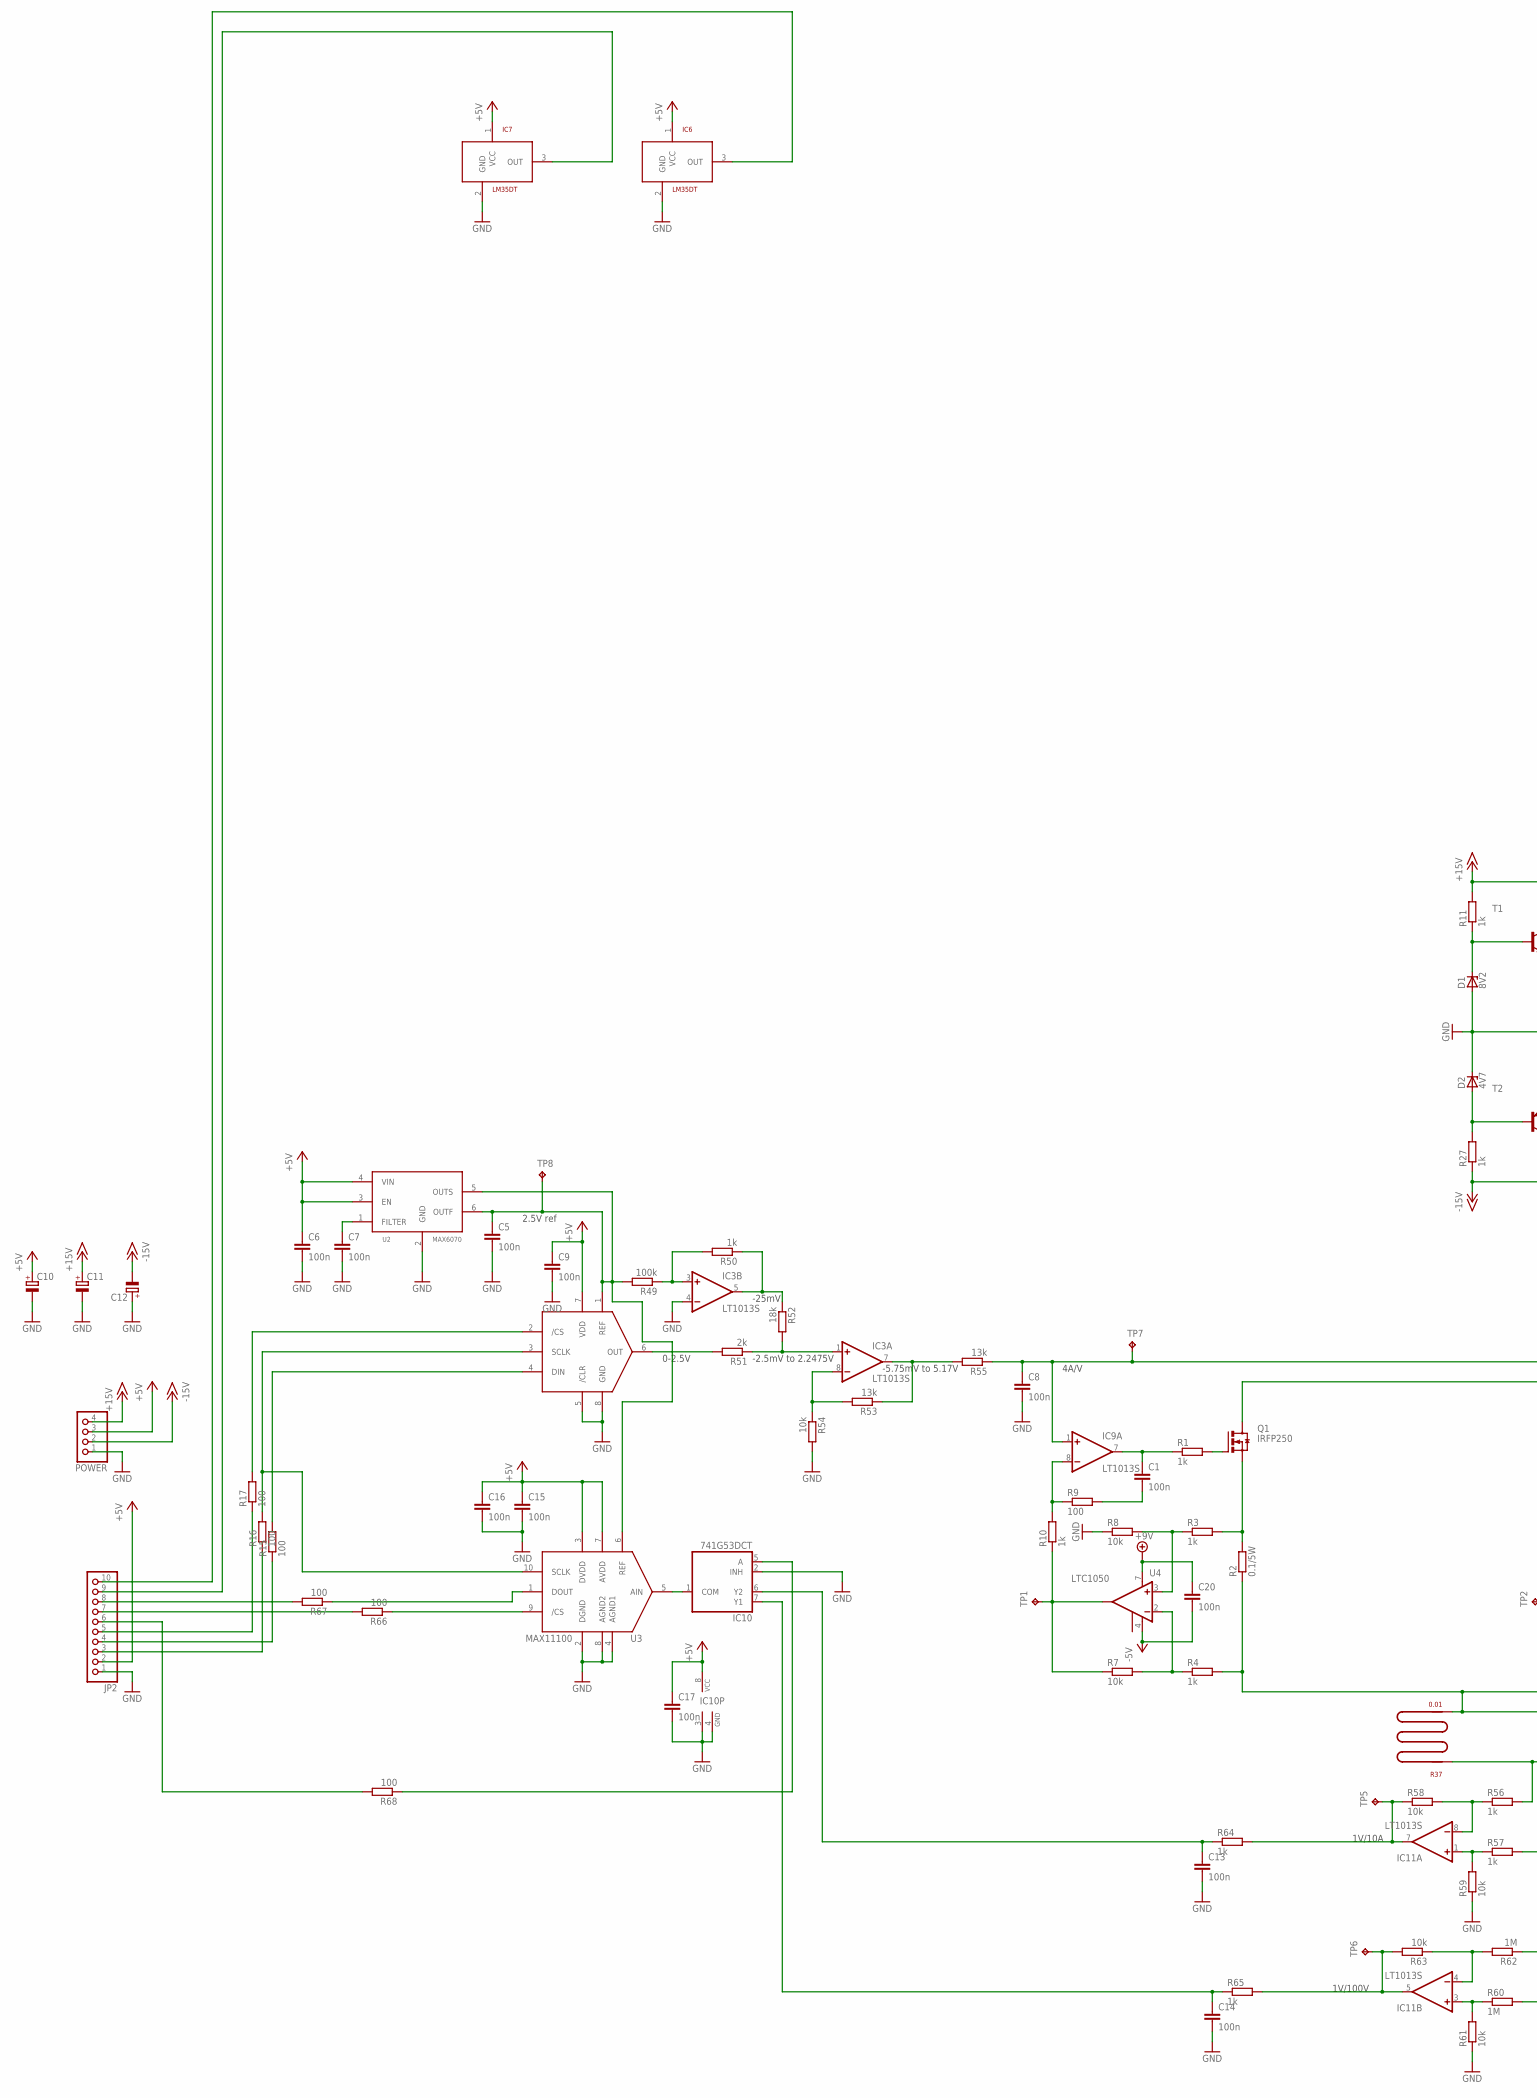
[picture p10: schematic analogBoardV1_2.sch, part in row 1, column 1]

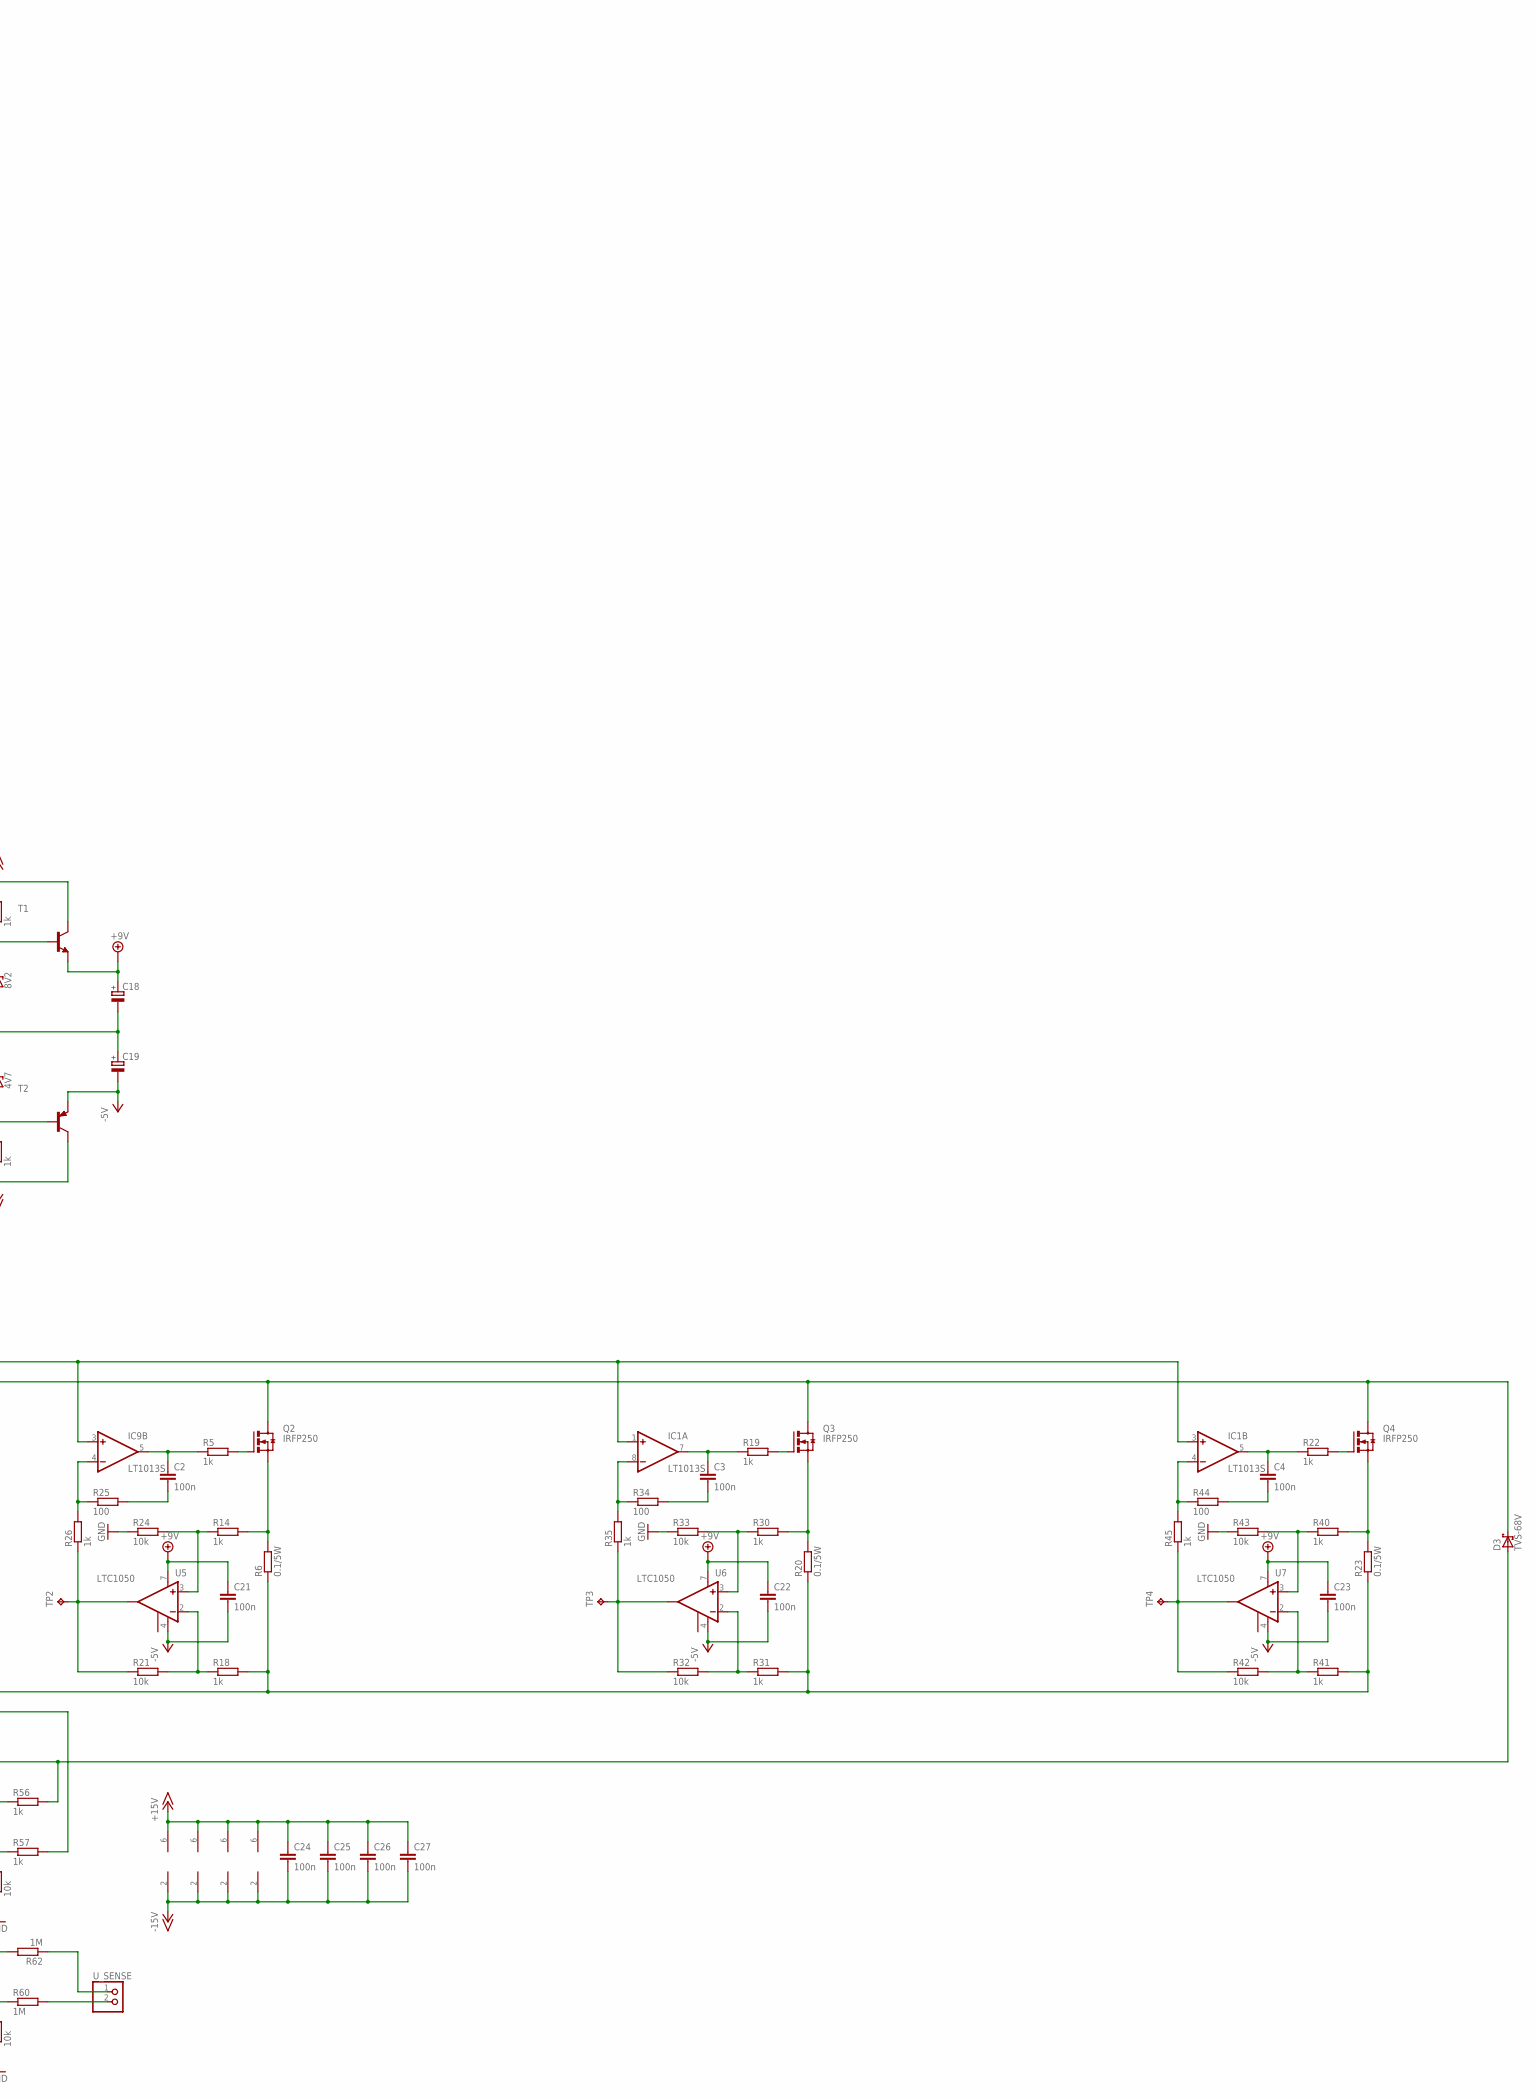
[picture p11: schematic analogBoardV1_2.sch, part in row 1, column 2]

Parts:
C1, C2, C3, C4, C5, C6, C7, C8, C9, C13, C14, C15, C16, C17, C20, C21, C22, C23, C24, C25, C26, C27: 100n; C0603K
C10, C11, C12, C18, C19: CPOL-EUE2.5-6; E2,5-6
D1: 8V2; SOT23
D2: 4V7; SOT23
D3: TVS-68V; CB429-15
IC1, IC3, IC9, IC11: LT1013S; SO08
IC6, IC7: LM35DT; TO220V
IC10: 741G53DCT; DCT_R-PDSO-G8
JP2: PINHD-1X10; 1X10
POWER: PINHD-1X4; 1X04
Q1, Q2, Q3, Q4: IRFP250; TO-247AD-V
R1, R3, R4, R5, R10, R11, R14, R18, R19, R22, R26, R27, R30, R31, R35, R40, R41, R45, R50, R56, R57, R64, R65: 1k; R0603
R2, R6, R20, R23: 0.1/5W; 5WAXIAL
R7, R8, R21, R24, R32, R33, R42, R43, R54, R58, R59, R61, R63: 10k; R0603
R9, R15, R16, R17, R25, R34, R44, R66, R67, R68: 100; R0603
R37: 0.01; COPPERSHUNT
R49: 100k; R0603
R51: 2k; R0603
R52: 18k; R0603
R53, R55: 13k; R0603
R60, R62: 1M; R0603
T1: BC817-16-NPN-SOT23-BEC; SOT23-BEC
T2: BC807-16-PNP-SOT23-BEC; SOT23-BEC
TP1, TP2, TP3, TP4, TP5, TP6, TP7, TP8: TPB1,27; B1,27
U1: MAX5216; UMAX8
U2: MAX6070; SOT23-6L
U3: MAX11100; UMAX10
U4, U5, U6, U7: LTC1050; SOIC8
U_SENSE: PINHD-1X2; 1X02

Connections:
1M: R62.1, U_SENSE.1
+5V: C6.1, C9.1, C10.+, C15.1, C16.1, C17.1, IC6.1 (VCC), IC7.1 (VCC), IC10.8 (VCC), JP2.2, POWER.3, U1.7 (VDD), U2.3 (EN), U2.4 (VIN), U3.3 (DVDD), U3.7 (AVDD)
+9V: C18.+, C20.1, C21.1, C22.1, C23.1, T1.E, U4.7 (V+), U5.7 (V+), U6.7 (V+), U7.7 (V+)
+15V: C11.+, C24.1, C25.1, C26.1, C27.1, IC1.6 (V+), IC3.6 (V+), IC9.6 (V+), IC11.6 (V+), POWER.4, R11.2, T1.C
-5V: C19.-, C20.2, C21.2, C22.2, C23.2, T2.E, U4.4 (V-), U5.4 (V-), U6.4 (V-), U7.4 (V-)
-15V: C12.-, C24.2, C25.2, C26.2, C27.2, IC1.2 (V-), IC3.2 (V-), IC9.2 (V-), IC11.2 (V-), POWER.2, R27.1, T2.C
GND: C5.2, C6.2, C7.2, C8.2, C9.2, C10.-, C11.-, C12.+, C13.2, C14.2, C15.2, C16.2, C17.2, C18.-, C19.+, D1.1 (A), D2.3 (C), IC3.4 (-IN), IC6.2 (GND), IC7.2 (GND), IC10.2 (INH), IC10.3 (GND), IC10.4 (GND), JP2.1, POWER.1, R8.1, R24.1, R33.1, R43.1, R54.2, R59.1, R61.1, U1.5 (/CLR), U1.8 (GND), U2.2 (GND), U3.2 (DGND), U3.4 (AGND1), U3.8 (AGND2)
unnamed: R2.1, R4.2, R6.1, R18.2, R20.1, R23.1, R31.2, R37.P$2, R41.2, R57.2
unnamed: Q1.G, R1.2
unnamed: Q1.S, R2.2, R3.2
unnamed: R4.1, R7.2, U4.2 (-IN)
unnamed: R3.1, R8.2, U4.3 (+IN)
unnamed: Q2.G, R5.2
unnamed: Q2.S, R6.2, R14.2
unnamed: C1.1, IC9.7 (OUT), R1.1
unnamed: C1.2, R9.2
unnamed: R7.1, R10.1, TP1.TP, U4.6 (OUT)
unnamed: IC9.8 (-IN), R9.1, R10.2
unnamed: D1.3 (C), R11.1, T1.B
unnamed: D2.1 (A), R27.2, T2.B
unnamed: Q3.G, R19.2
unnamed: R15.2, U1.4 (DIN)
unnamed: Q3.S, R20.2, R30.2
unnamed: R16.2, U1.3 (SCLK), U3.10 (SCLK)
unnamed: R17.2, U1.2 (/CS)
unnamed: C8.1, IC1.1 (+IN), IC1.3 (+IN), IC9.1 (+IN), IC9.3 (+IN), R55.1, TP7.TP
unnamed: C7.1, U2.1 (FILTER)
unnamed: Q4.G, R22.2
unnamed: Q4.S, R23.2, R40.2
unnamed: C5.1, R49.2, TP8.TP, U1.1 (REF), U2.5 (OUTS), U2.6 (OUTF), U3.6 (REF)
unnamed: R51.2, U1.6 (OUT)
unnamed: R18.1, R21.2, U5.2 (-IN)
unnamed: R14.1, R24.2, U5.3 (+IN)
unnamed: C2.1, IC9.5 (OUT), R5.1
unnamed: C2.2, R25.2
unnamed: R21.1, R26.1, TP2.TP, U5.6 (OUT)
unnamed: IC9.4 (-IN), R25.1, R26.2
unnamed: IC3.3 (+IN), R49.1, R50.2
unnamed: IC3.5 (OUT), R50.1, R52.1
unnamed: IC3.1 (+IN), R51.1, R52.2
unnamed: IC3.8 (-IN), R53.2, R54.1
unnamed: R31.1, R32.2, U6.2 (-IN)
unnamed: R30.1, R33.2, U6.3 (+IN)
unnamed: C3.1, IC1.7 (OUT), R19.1
unnamed: JP2.5, R17.1
unnamed: JP2.3, R16.1
unnamed: JP2.4, R15.1
unnamed: C3.2, R34.2
unnamed: IC6.3 (OUT), JP2.10
unnamed: IC7.3 (OUT), JP2.9
unnamed: R32.1, R35.1, TP3.TP, U6.6 (OUT)
unnamed: IC1.8 (-IN), R34.1, R35.2
unnamed: IC3.7 (OUT), R53.1, R55.2
unnamed: IC10.1 (COM), U3.5 (AIN)
unnamed: R41.1, R42.2, U7.2 (-IN)
unnamed: R40.1, R43.2, U7.3 (+IN)
unnamed: C4.1, IC1.5 (OUT), R22.1
unnamed: C4.2, R44.2
unnamed: R42.1, R45.1, TP4.TP, U7.6 (OUT)
unnamed: IC1.4 (-IN), R44.1, R45.2
unnamed: D3.A, R37.P$1, R56.2
unnamed: IC11.5 (OUT), R63.2, R65.2, TP6.TP
unnamed: IC11.8 (-IN), R56.1, R58.2
unnamed: IC11.1 (+IN), R57.1, R59.2
unnamed: C13.1, IC10.6 (Y2), R64.1
unnamed: IC11.7 (OUT), R58.1, R64.2, TP5.TP
unnamed: R60.2, U_SENSE.2
unnamed: IC11.3 (+IN), R60.1, R61.2
unnamed: IC11.4 (-IN), R62.2, R63.1
unnamed: C14.1, IC10.7 (Y1), R65.1
unnamed: IC10.5 (A), R68.1
unnamed: JP2.7, R66.2
unnamed: R67.1, U3.1 (DOUT)
unnamed: R66.1, U3.9 (/CS)
unnamed: JP2.8, R67.2
unnamed: JP2.6, R68.2
POS_INPUT1: D3.C, Q1.D, Q2.D, Q3.D, Q4.D

Notes on the sheet:
4A/V
0-2.5V
2.5V ref
-25mV
-2.5mV to 2.2475V
-5.75mV to 5.17V
1V/10A
1V/100V

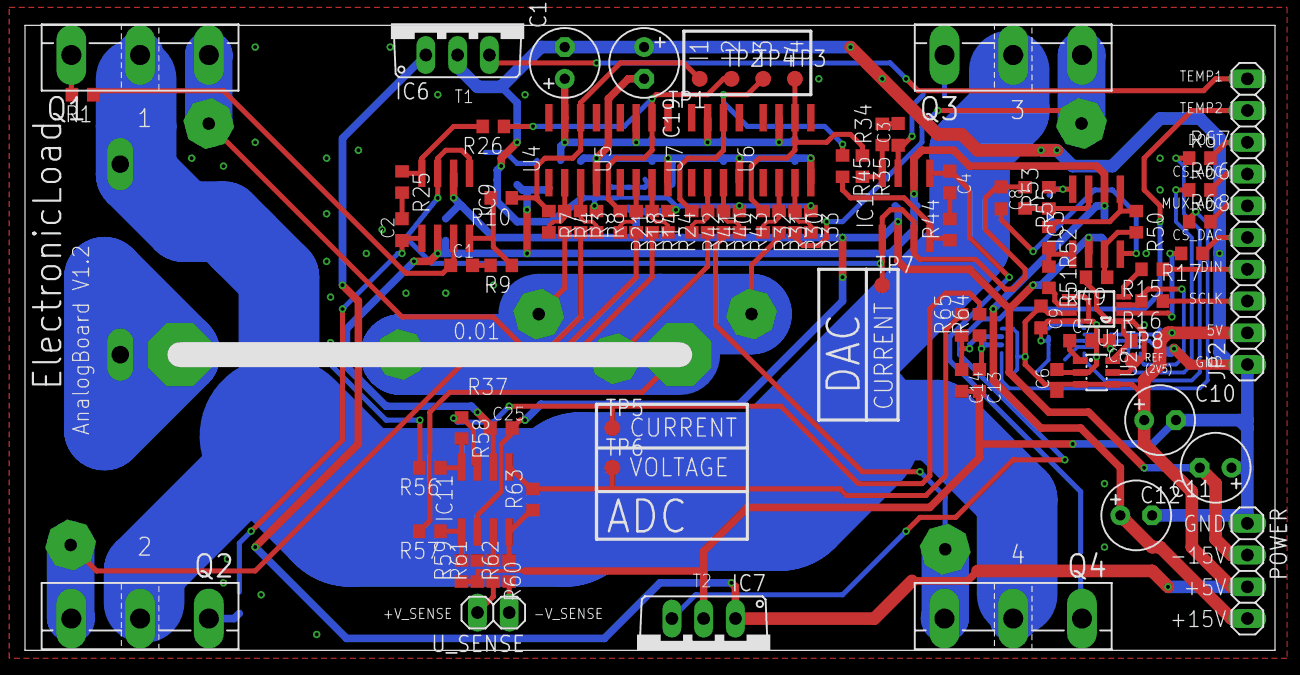
[picture p12: board analogBoardV1_2.brd from above]

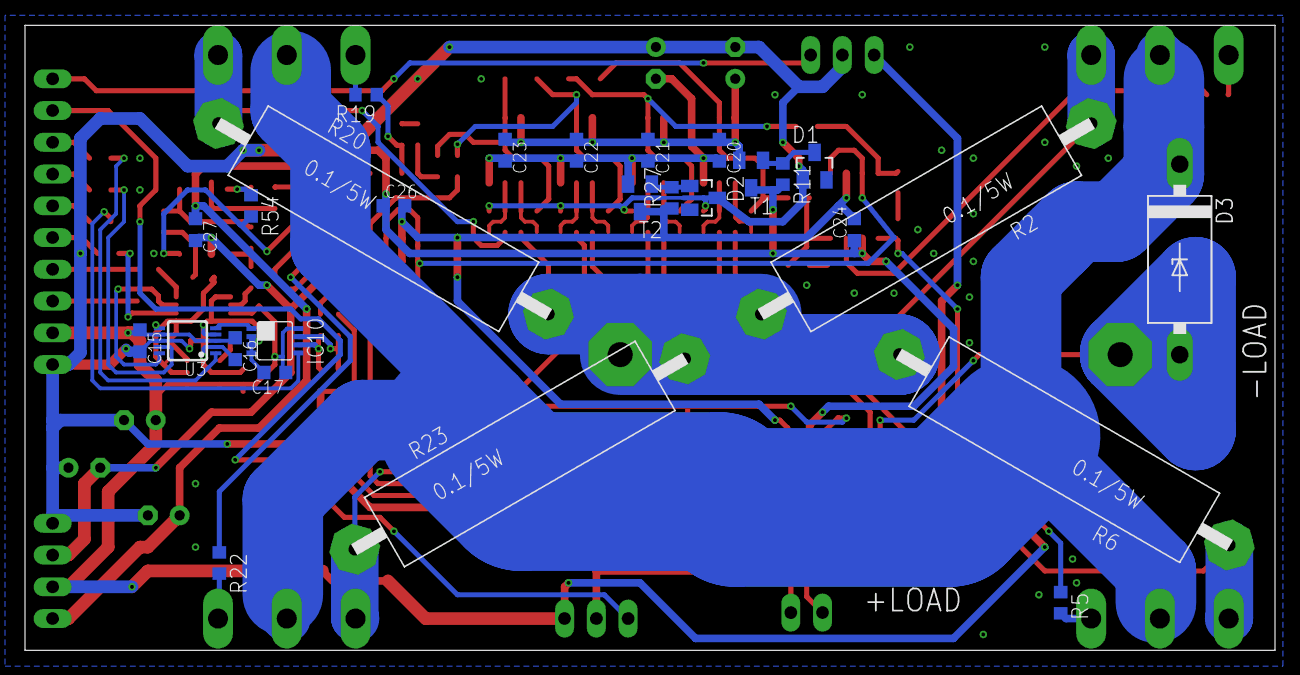
[picture p13: board analogBoardV1_2.brd from below]

Board: 2 copper layers, 100.0 x 50.0 mm, 119 parts (27 on the bottom side), 77 nets.
