jankae/electronicload/hardware/pcb/powerSupplyV1.brd

## EAGLE design hardware/pcb/powerSupplyV1.brd (2016-02-01)

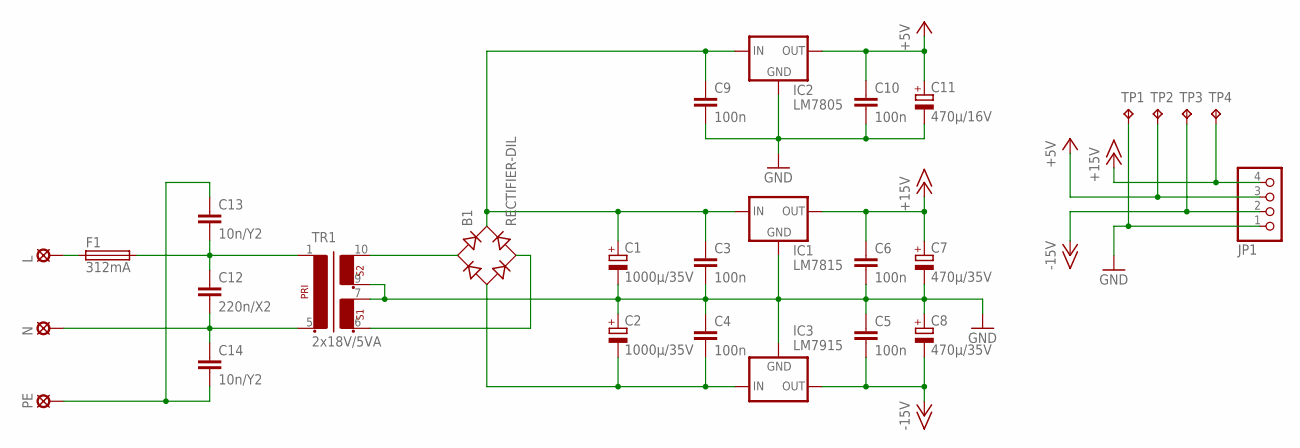
[picture p14: schematic powerSupplyV1.sch]

Parts:
B1: RECTIFIER-DIL; B-DIL
C1, C2: 1000µ/35V; E5-13
C3, C4, C5, C6, C9, C10: 100n; C0603K
C7, C8: 470µ/35V; E5-10,5
C11: 470µ/16V; E5-10,5
C12: 220n/X2; C225-062X268
C13, C14: 10n/Y2; C150-054X183
F1: 312mA; SH22,5
IC1: LM7815; 78XXS
IC2: LM7805; 78XXS
IC3: LM7915; 79XXS
JP1: PINHD-1X4; 1X04
L: L; SE14
N: SE14
PE: SE14
TP1, TP2, TP3, TP4: TPB2,54; B2,54
TR1: 2x18V/5VA; EI42-2

Connections:
+5V: C10.1, C11.+, IC2.OUT, JP1.3, TP2.TP
+15V: C6.1, C7.+, IC1.OUT, JP1.4, TP4.TP
-15V: C5.2, C8.-, IC3.OUT, JP1.2, TP3.TP
GND: C1.-, C2.+, C3.2, C4.1, C5.1, C6.2, C7.-, C8.+, C9.2, C10.2, C11.-, IC1.GND, IC2.GND, IC3.GND, JP1.1, TP1.TP, TR1.7 (4), TR1.9 (5)
unnamed: B1.AC1, TR1.10 (6)
unnamed: B1.AC2, TR1.6 (3)
unnamed: C12.1, C13.2, F1.2, TR1.1
unnamed: B1.-, C2.-, C4.2, IC3.IN
unnamed: B1.+, C1.+, C3.1, C9.1, IC1.IN, IC2.IN
unnamed: C12.2, C14.1, N.MP, TR1.5 (2)
unnamed: C13.1, C14.2, PE.MP
unnamed: F1.1, L.MP

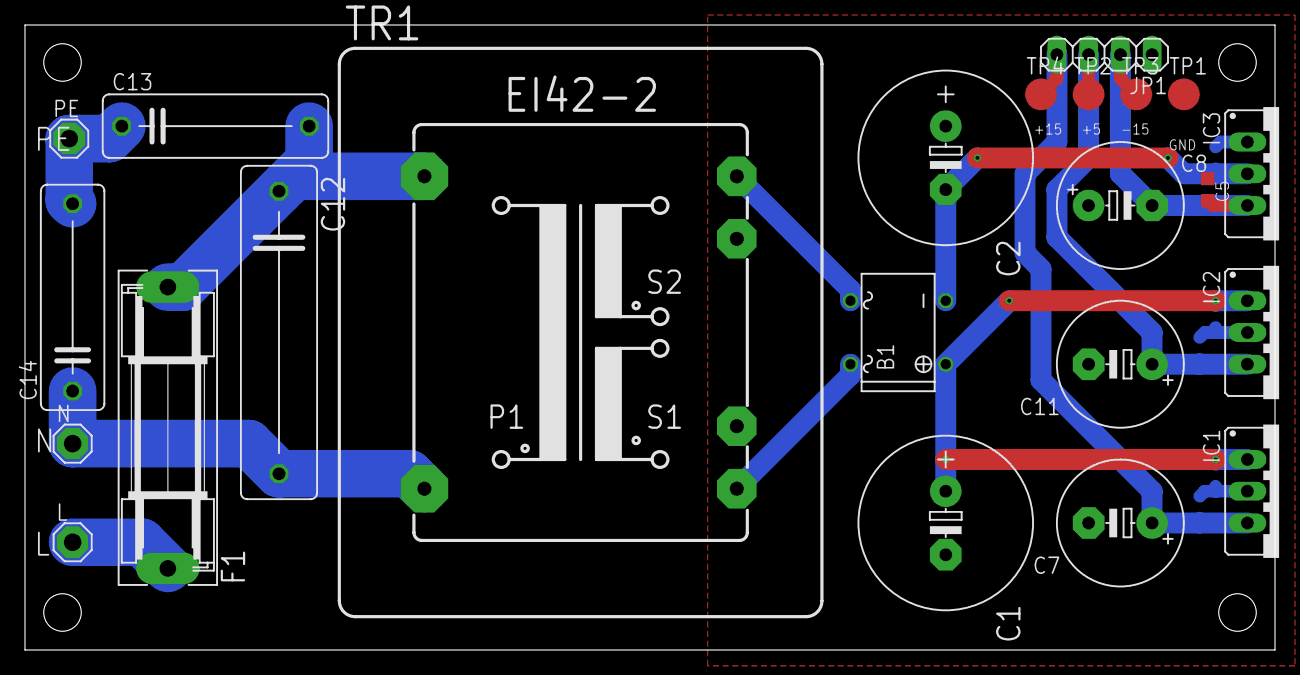
[picture p15: board powerSupplyV1.brd from above]

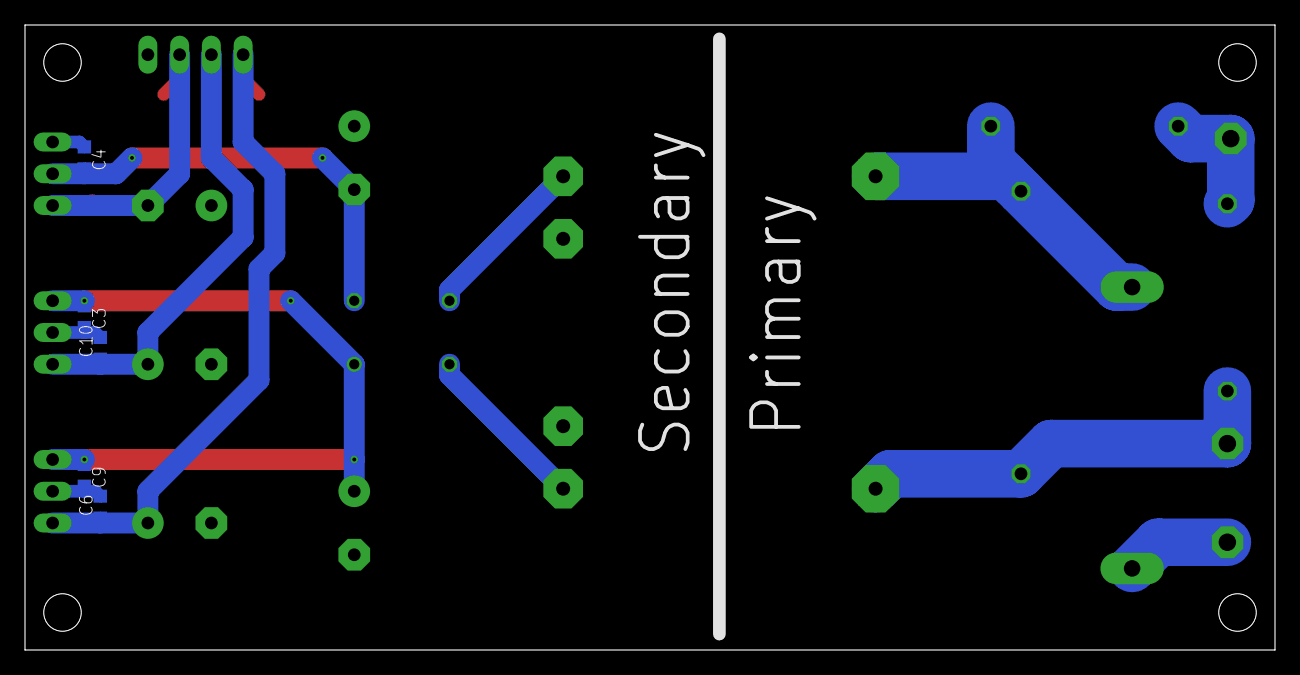
[picture p16: board powerSupplyV1.brd from below]

Board: 2 copper layers, 100.0 x 50.0 mm, 28 parts (5 on the bottom side), 12 nets.
