jankae/electronicload/hardware/pcb/analogBoardV1.brd

## EAGLE design hardware/pcb/analogBoardV1.brd (2016-02-01, an earlier design)

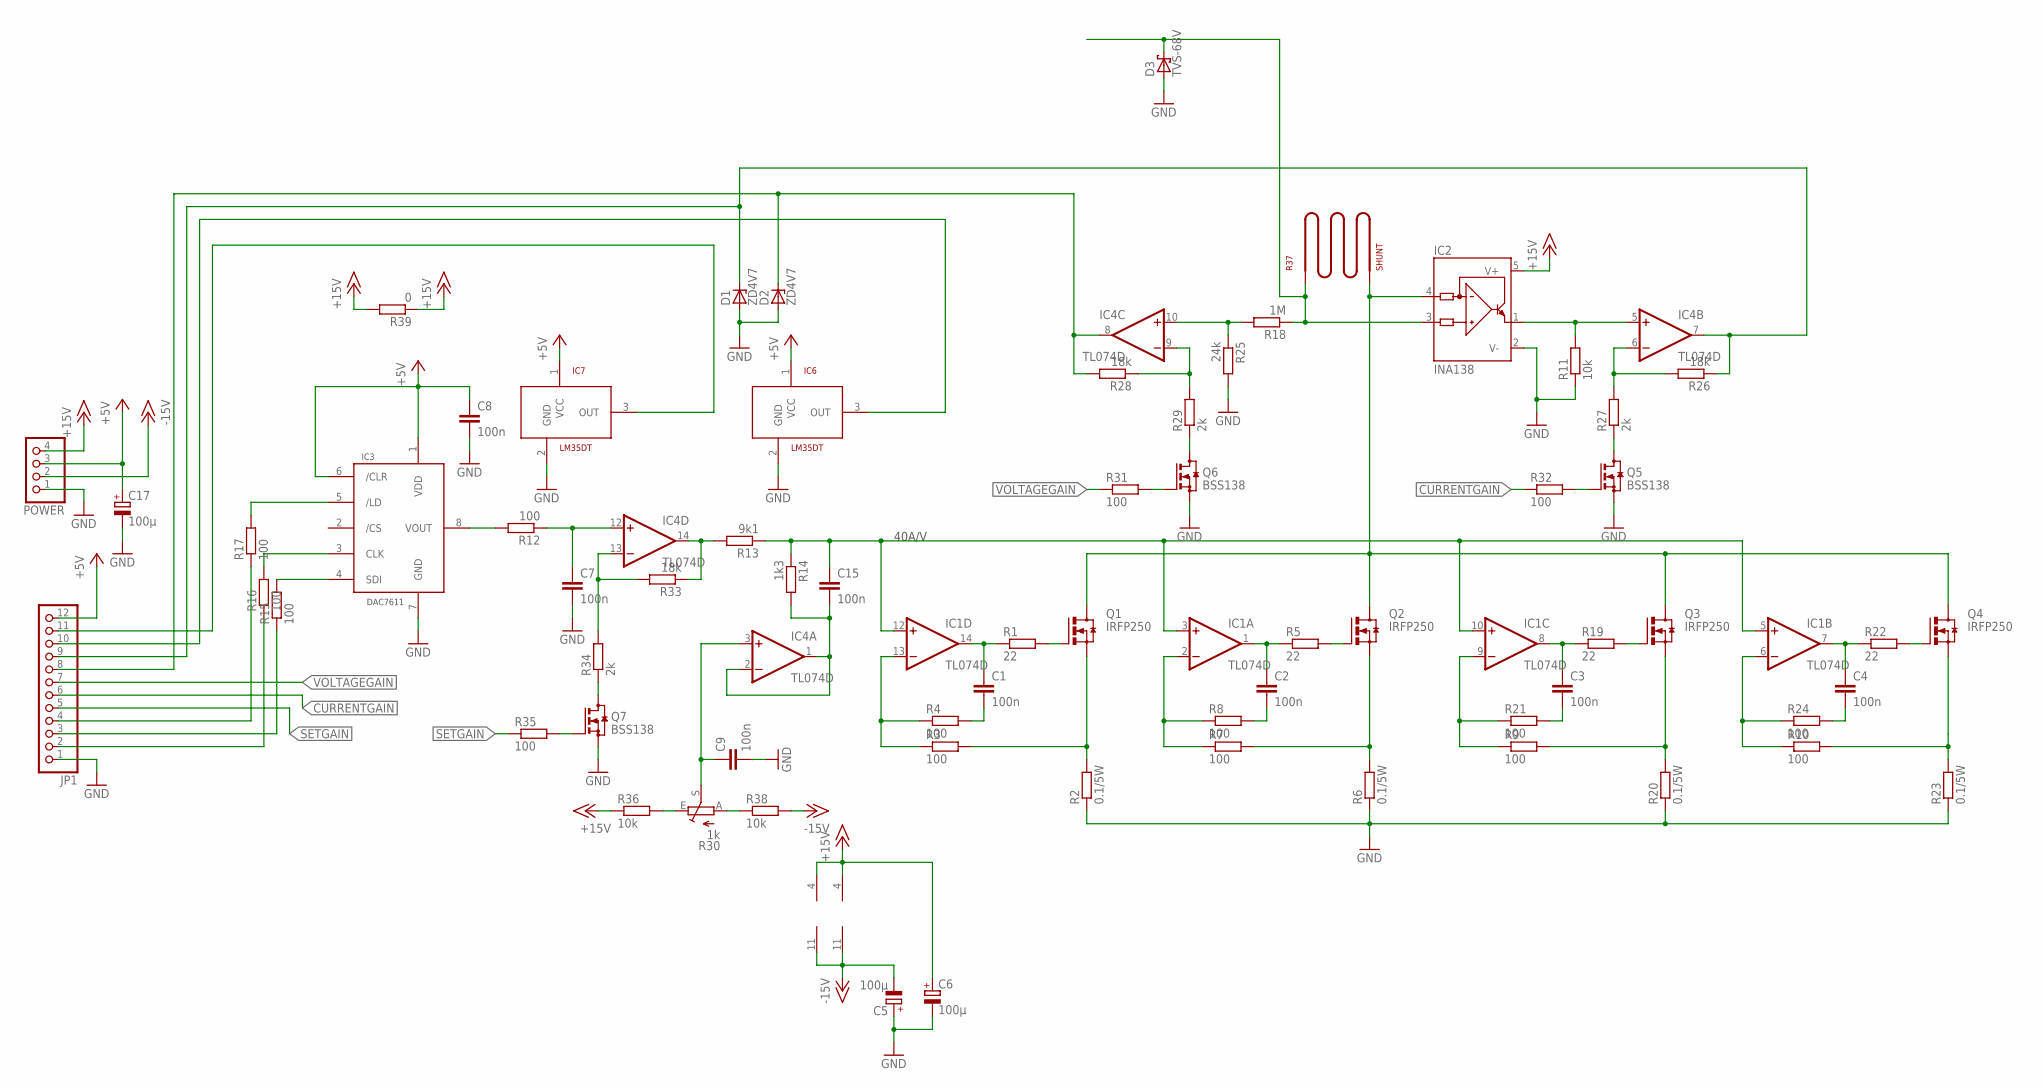
[picture p17: schematic analogBoardV1.sch]

Parts:
C1, C2, C3, C4, C7, C8, C9, C15: 100n; C0603K
C5, C6, C17: 100µ; E2,5-6
D1, D2: ZD4V7; SOT23
D3: TVS-68V; CB429-15
IC1, IC4: TL074D; SO14
IC2: INA138; SOT23-5
IC3: DAC7611; SO8
IC6, IC7: LM35DT; TO220V
JP1: PINHD-1X12; 1X12
POWER: PINHD-1X4; 1X04
Q1, Q2, Q3, Q4: IRFP250; TO-247AD-V
Q5, Q6, Q7: BSS138; SOT23
R1, R5, R19, R22: 22; R0603
R2, R6, R20, R23: 0.1/5W; 5WAXIAL
R3, R4, R7, R8, R9, R10, R12, R15, R16, R17, R21, R24, R31, R32, R35: 100; R0603
R11, R36, R38: 10k; R0603
R13: 9k1; R0603
R14: 1k3; R0603
R18: 1M; R0603
R25: 24k; R0603
R26, R28, R33: 18k; R0603
R27, R29, R34: 2k; R0603
R30: 1k; RJ9W
R37: SHUNT; COPPERSHUNT
R39: 0; R1206

Connections:
10: IC4.9 (-IN), R28.1, R29.2
+5V: C8.1, C17.+, IC3.1 (VDD), IC3.6 (/CLR), IC6.1 (VCC), IC7.1 (VCC), JP1.12, POWER.3
+15V: C6.+, IC1.4 (V+), IC2.5 (V+), IC4.4 (V+), POWER.4, R36.1, R39.1, R39.2
-15V: C5.-, IC1.11 (V-), IC4.11 (V-), POWER.2, R38.2
CURRENTGAIN: JP1.6, R32.1
GND: C5.+, C6.-, C7.2, C8.2, C9.2, C17.-, D1.1 (A), D2.1 (A), D3.A, IC2.2 (V-), IC3.7 (GND), IC6.2 (GND), IC7.2 (GND), JP1.1, POWER.1, Q5.2 (S), Q6.2 (S), Q7.2 (S), R2.1, R6.1, R11.1, R20.1, R23.1, R25.2
unnamed: C1.1, IC1.14 (OUT), R1.1
unnamed: Q1.G, R1.2
unnamed: Q1.S, R2.2, R3.2
unnamed: C1.2, R4.2
unnamed: IC1.13 (-IN), R3.1, R4.1
unnamed: C2.1, IC1.1 (OUT), R5.1
unnamed: Q2.G, R5.2
unnamed: Q2.S, R6.2, R7.2
unnamed: IC1.2 (-IN), R7.1, R8.1
unnamed: C2.2, R8.2
unnamed: D3.C, IC2.3 (IN+), R18.1, R37.P$1
unnamed: IC2.1 (OUT), IC4.5 (+IN), R11.2
unnamed: IC3.8 (VOUT), R12.2
unnamed: C3.1, IC1.8 (OUT), R19.1
unnamed: Q3.G, R19.2
unnamed: C7.1, IC4.12 (+IN), R12.1
unnamed: IC4.14 (OUT), R13.2, R33.1
unnamed: IC3.4 (SDI), R15.2
unnamed: Q3.S, R9.2, R20.2
unnamed: IC1.9 (-IN), R9.1, R21.1
unnamed: IC3.3 (CLK), R16.2
unnamed: IC3.5 (/LD), R17.2
unnamed: C3.2, R21.2
unnamed: C4.1, IC1.7 (OUT), R22.1
unnamed: D1.3 (C), IC4.7 (OUT), JP1.9, R26.1
unnamed: Q4.G, R22.2
unnamed: Q4.S, R10.2, R23.2
unnamed: IC1.6 (-IN), R10.1, R24.1
unnamed: C4.2, R24.2
unnamed: C15.2, IC4.1 (OUT), IC4.2 (-IN), R14.2
unnamed: C15.1, IC1.3 (+IN), IC1.5 (+IN), IC1.10 (+IN), IC1.12 (+IN), R13.1, R14.1
unnamed: R30.A, R38.1
unnamed: IC4.10 (+IN), R18.2, R25.1
unnamed: R30.E, R36.2
unnamed: IC4.6 (-IN), R26.2, R27.2
unnamed: Q5.3 (D), R27.1
unnamed: Q6.3 (D), R29.1
unnamed: D2.3 (C), IC4.8 (OUT), JP1.8, R28.2
unnamed: Q5.1 (G), R32.2
unnamed: Q6.1 (G), R31.2
unnamed: IC4.13 (-IN), R33.2, R34.2
unnamed: Q7.3 (D), R34.1
unnamed: Q7.1 (G), R35.2
unnamed: C9.1, IC4.3 (+IN), R30.S
unnamed: JP1.4, R17.1
unnamed: JP1.2, R16.1
unnamed: JP1.3, R15.1
unnamed: IC6.3 (OUT), JP1.10
unnamed: IC7.3 (OUT), JP1.11
POS_INPUT1: IC2.4 (IN-), Q1.D, Q2.D, Q3.D, Q4.D, R37.P$2
SETGAIN: JP1.5, R35.1
VOLTAGEGAIN: JP1.7, R31.1

Notes on the sheet:
40A/V

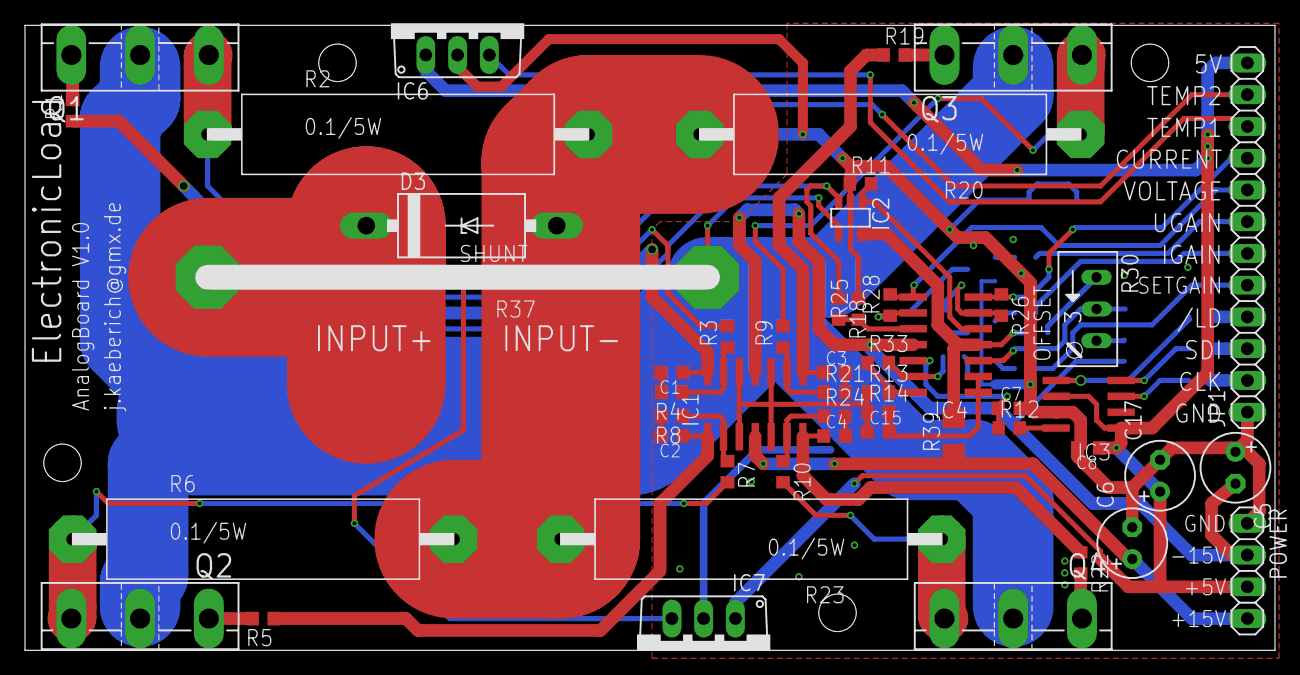
[picture p18: board analogBoardV1.brd from above]

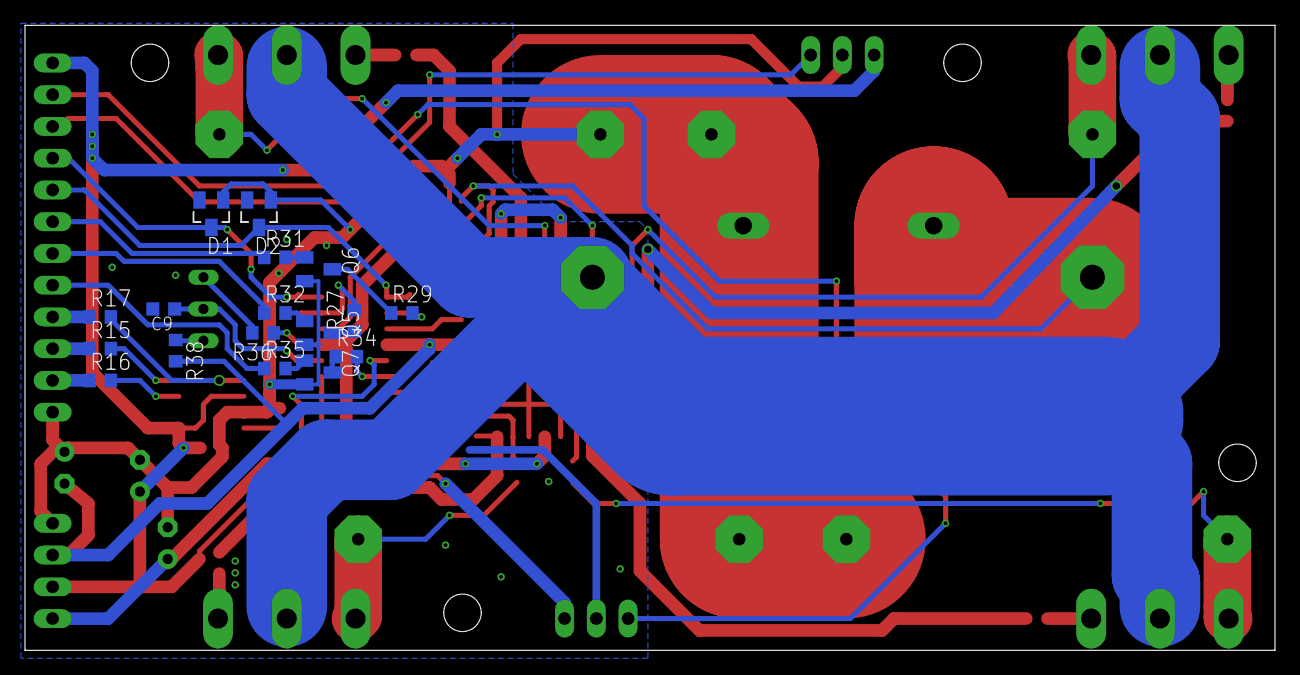
[picture p19: board analogBoardV1.brd from below]

Board: 2 copper layers, 100.0 x 50.0 mm, 68 parts (17 on the bottom side), 58 nets.
