jankae/electronicload/hardware/pcb/digitalBoardV1_1.brd

## EAGLE design hardware/pcb/digitalBoardV1_1.brd (2016-02-01)

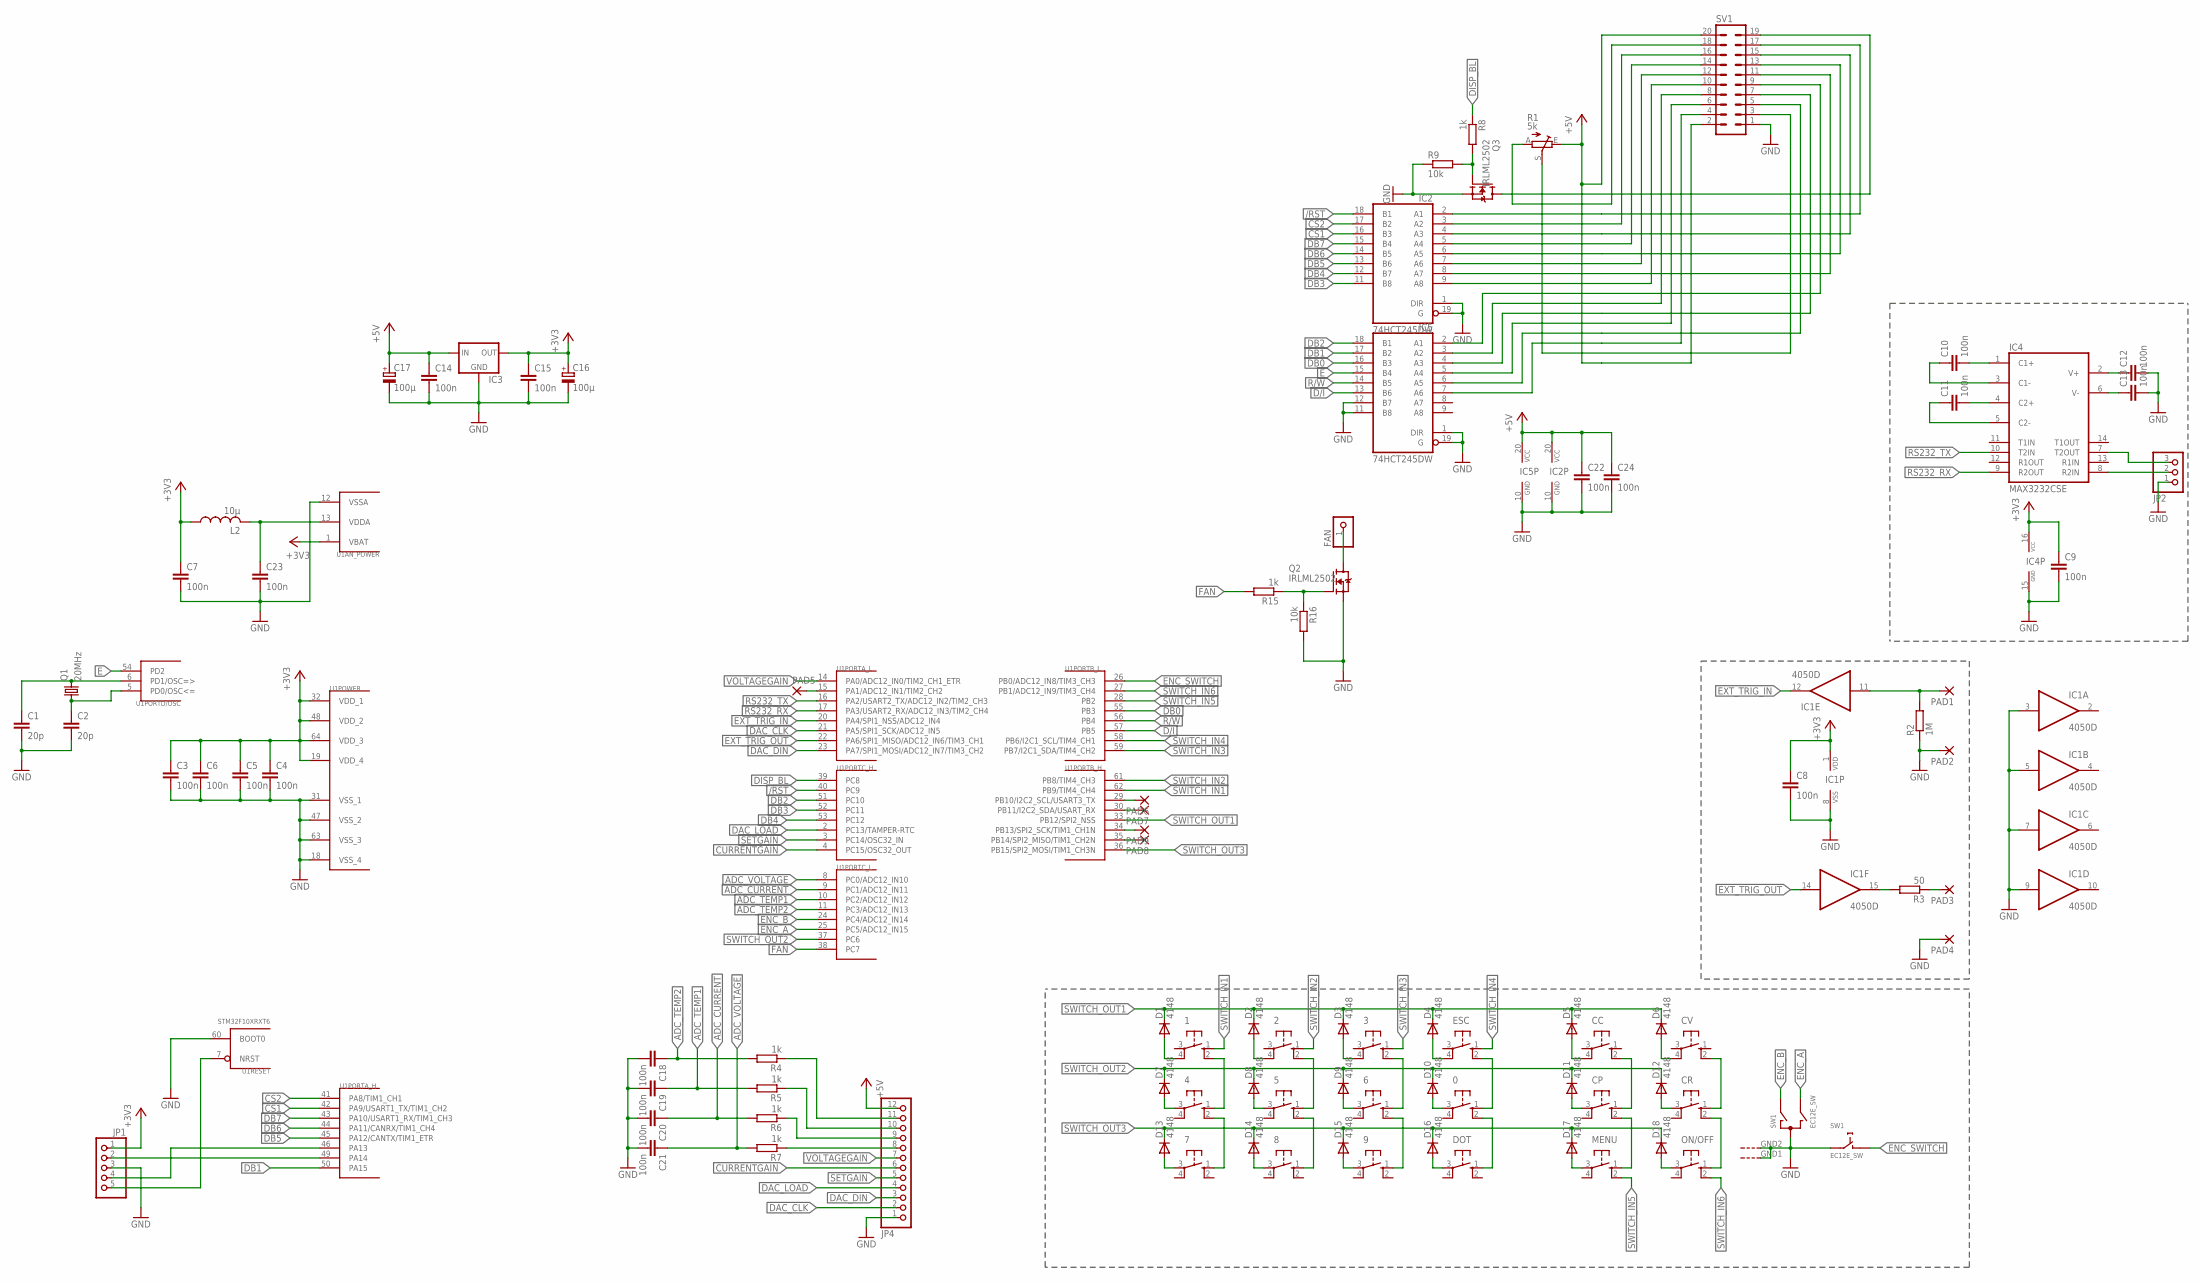
[picture p20: schematic digitalBoardV1_1.sch]

Parts:
0, 1, 2, 3, 4, 5, 6, 7, 8, 9: 10-XXSMD; SMD
C1, C2: 20p; C0603K
C3, C4, C5, C6, C7, C8, C9, C10, C11, C12, C13, C14, C15, C18, C19, C20, C21, C22, C23, C24: 100n; C0603K
C16, C17: 100µ; E2,5-6
CC: 10-XXSMD; SMD
CP: 10-XXSMD; SMD
CR: 10-XXSMD; SMD
CV: 10-XXSMD; SMD
D1, D2, D3, D4, D5, D6, D7, D8, D9, D10, D11, D12, D13, D14, D15, D16, D17, D18: 4148; SOD323-R
DOT: 10-XXSMD; SMD
ESC: 10-XXSMD; SMD
FAN: PINHD-1X1; 1X01
IC1: 4050D; SO16
IC2, IC5: 74HCT245DW; SO20W
IC3: LM1117; SOT223
IC4: MAX3232CSE; SO16
JP1: PINHD-1X5; 1X05
JP2: PINHD-1X3; 1X03
JP4: PINHD-1X12; 1X12
L2: 10µ; R0805
MENU: 10-XXSMD; SMD
ON/OFF: 10-XXSMD; SMD
PAD1, PAD2, PAD3, PAD4, PAD5, PAD6, PAD7, PAD8, PAD9: SMD2; SMD1,27-2,54
Q1: 20MHz; CTS406
Q2, Q3: IRLML2502; SOT23-3
R1: 5k; RJ9W
R2: 1M; R0603
R3: 50; R0603
R4, R5, R6, R7, R8, R15: 1k; R0603
R9, R16: 10k; R0603
SV1: ML20
SW1: EC12E_SW; ALPS_EC12E_SW
U1: STM32F10XRXT6; TQFP64

Connections:
+3V3: C3.1, C4.1, C5.1, C6.1, C7.1, C8.1, C9.1, C15.1, C16.+, IC1.1 (VDD), IC3.2 (OUT), IC4.16 (VCC), JP1.1, L2.1, U1.1 (VBAT), U1.19 (VDD_4), U1.32 (VDD_1), U1.48 (VDD_2), U1.64 (VDD_3)
+5V: C14.1, C17.+, C22.1, C24.1, IC2.20 (VCC), IC3.3 (IN), IC5.20 (VCC), JP4.12, R1.E, SV1.2, SV1.20
/RST: IC2.18 (B1), U1.40 (PC9)
ADC_CURRENT: C20.1, R6.2, U1.9 (PC1/ADC12_IN11)
ADC_TEMP1: C19.1, R5.2, U1.10 (PC2/ADC12_IN12)
ADC_TEMP2: C18.1, R4.2, U1.11 (PC3/ADC12_IN13)
ADC_VOLTAGE: C21.1, R7.2, U1.8 (PC0/ADC12_IN10)
CS1: IC2.16 (B3), U1.42 (PA9/USART1_TX/TIM1_CH2)
CS2: IC2.17 (B2), U1.41 (PA8/TIM1_CH1)
CURRENTGAIN: JP4.6, U1.4 (PC15/OSC32_OUT)
D/I: IC5.13 (B6), U1.57 (PB5)
DAC_CLK: JP4.2, U1.21 (PA5/SPI1_SCK/ADC12_IN5)
DAC_DIN: JP4.3, U1.23 (PA7/SPI1_MOSI/ADC12_IN7/TIM3_CH2)
DAC_LOAD: JP4.4, U1.2 (PC13/TAMPER-RTC)
DB0: IC5.16 (B3), U1.55 (PB3)
DB1: IC5.17 (B2), U1.50 (PA15)
DB2: IC5.18 (B1), U1.51 (PC10)
DB3: IC2.11 (B8), U1.52 (PC11)
DB4: IC2.12 (B7), U1.53 (PC12)
DB5: IC2.13 (B6), U1.45 (PA12/CANTX/TIM1_ETR)
DB6: IC2.14 (B5), U1.44 (PA11/CANRX/TIM1_CH4)
DB7: IC2.15 (B4), U1.43 (PA10/USART1_RX/TIM1_CH3)
DISP_BL: R8.1, U1.39 (PC8)
E: IC5.15 (B4), U1.54 (PD2)
ENC_A: SW1.B, U1.25 (PC5/ADC12_IN15)
ENC_B: SW1.A, U1.24 (PC4/ADC12_IN14)
ENC_SWITCH: SW1.D (1), U1.26 (PB0/ADC12_IN8/TIM3_CH3)
EXT_TRIG_IN: IC1.12 (O), U1.20 (PA4/SPI1_NSS/ADC12_IN4)
EXT_TRIG_OUT: IC1.14 (I), U1.22 (PA6/SPI1_MISO/ADC12_IN6/TIM3_CH1)
FAN: R15.2, U1.38 (PC7)
GND: C1.2, C2.2, C3.2, C4.2, C5.2, C6.2, C7.2, C8.2, C9.2, C12.2, C13.2, C14.2, C15.2, C16.-, C17.-, C18.2, C19.2, C20.2, C21.2, C22.2, C23.2, C24.2, IC1.3 (I), IC1.5 (I), IC1.7 (I), IC1.8 (VSS), IC1.9 (I), IC2.1 (DIR), IC2.10 (GND), IC2.19 (G), IC3.1 (GND), IC4.15 (GND), IC5.1 (DIR), IC5.10 (GND), IC5.11 (B8), IC5.12 (B7), IC5.19 (G), JP1.3, JP2.1, JP4.1, PAD2.1, PAD4.1, Q2.2 (S), Q3.2 (S), R2.1, R9.1, R16.2, SV1.1, SW1.C, SW1.E (2), SW1.GND1 (G), SW1.GND2 (G), U1.12 (VSSA), U1.18 (VSS_4), U1.31 (VSS_1), U1.47 (VSS_2), U1.60 (BOOT0), U1.63 (VSS_3)
unnamed: C1.1, Q1.3 (2), U1.6 (PD1/OSC=>)
unnamed: C2.1, Q1.1, U1.5 (PD0/OSC<=)
unnamed: IC1.11 (I), PAD1.1, R2.2
unnamed: IC1.15 (O), R3.2
unnamed: PAD3.1, R3.1
unnamed: C10.2, IC4.1 (C1+)
unnamed: C10.1, IC4.3 (C1-)
unnamed: C11.2, IC4.4 (C2+)
unnamed: C11.1, IC4.5 (C2-)
unnamed: C13.1, IC4.6 (V-)
unnamed: C12.1, IC4.2 (V+)
unnamed: JP4.8, R7.1
unnamed: JP4.9, R6.1
unnamed: R1.A, SV1.18
unnamed: JP4.10, R5.1
unnamed: JP4.11, R4.1
unnamed: 0.1 (S), ESC.2 (S1)
unnamed: 0.2 (S1), DOT.1 (S)
unnamed: C23.1, L2.2, U1.13 (VDDA)
unnamed: IC4.8 (R2IN), JP2.2
unnamed: 4.2 (S1), 7.1 (S)
unnamed: 1.2 (S1), 4.1 (S)
unnamed: 2.2 (S1), 5.1 (S)
unnamed: 5.2 (S1), 8.1 (S)
unnamed: 3.2 (S1), 6.1 (S)
unnamed: 6.2 (S1), 9.1 (S)
unnamed: CC.2 (S1), CP.1 (S)
unnamed: CP.2 (S1), MENU.1 (S)
unnamed: CR.1 (S), CV.2 (S1)
unnamed: CR.2 (S1), ON/OFF.1 (S)
unnamed: IC4.7 (T2OUT), JP2.3
unnamed: 1.4 (P1), D1.A
unnamed: 2.4 (P1), D2.A
unnamed: 3.4 (P1), D3.A
unnamed: D4.A, ESC.4 (P1)
unnamed: CC.4 (P1), D5.A
unnamed: CV.4 (P1), D6.A
unnamed: 4.3, D7.A
unnamed: 7.3, D13.A
unnamed: 8.3, D14.A
unnamed: 5.3, D8.A
unnamed: 6.3, D9.A
unnamed: 9.3, D15.A
unnamed: D16.A, DOT.3
unnamed: PAD9.1, U1.34 (PB13/SPI2_SCK/TIM1_CH1N)
unnamed: 0.3, D10.A
unnamed: CP.3, D11.A
unnamed: D17.A, MENU.3
unnamed: PAD8.1, U1.35 (PB14/SPI2_MISO/TIM1_CH2N)
unnamed: Q2.1 (G), R15.1, R16.1
unnamed: FAN.1, Q2.3 (D)
unnamed: D18.A, ON/OFF.3
unnamed: CR.3, D12.A
unnamed: R1.S, SV1.3
unnamed: Q3.1 (G), R8.2, R9.2
unnamed: IC2.2 (A1), SV1.17
unnamed: IC2.3 (A2), SV1.16
unnamed: IC2.4 (A3), SV1.15
unnamed: IC2.5 (A4), SV1.14
unnamed: IC2.6 (A5), SV1.13
unnamed: IC2.7 (A6), SV1.12
unnamed: IC2.8 (A7), SV1.11
unnamed: IC2.9 (A8), SV1.10
unnamed: IC5.2 (A1), SV1.9
unnamed: IC5.3 (A2), SV1.8
unnamed: IC5.4 (A3), SV1.7
unnamed: IC5.5 (A4), SV1.6
unnamed: IC5.6 (A5), SV1.5
unnamed: Q3.3 (D), SV1.19
unnamed: IC5.7 (A6), SV1.4
unnamed: PAD7.1, U1.30 (PB11/I2C2_SDA/USART_RX)
unnamed: PAD6.1, U1.29 (PB10/I2C2_SCL/USART3_TX)
unnamed: PAD5.1, U1.15 (PA1/ADC12_IN1/TIM2_CH2)
NRST: JP1.5, U1.7 (NRST)
R/W: IC5.14 (B5), U1.56 (PB4)
RS232_RX: IC4.9 (R2OUT), U1.17 (PA3/USART2_RX/ADC12_IN3/TIM2_CH4)
RS232_TX: IC4.10 (T2IN), U1.16 (PA2/USART2_TX/ADC12_IN2/TIM2_CH3)
SETGAIN: JP4.5, U1.3 (PC14/OSC32_IN)
SWCLK: JP1.2, U1.49 (PA14)
SWDIO: JP1.4, U1.46 (PA13)
SWITCH_IN1: 1.1 (S), U1.62 (PB9/TIM4_CH4)
SWITCH_IN2: 2.1 (S), U1.61 (PB8/TIM4_CH3)
SWITCH_IN3: 3.1 (S), U1.59 (PB7/I2C1_SDA/TIM4_CH2)
SWITCH_IN4: ESC.1 (S), U1.58 (PB6/I2C1_SCL/TIM4_CH1)
SWITCH_IN5: MENU.2 (S1), U1.28 (PB2)
SWITCH_IN6: ON/OFF.2 (S1), U1.27 (PB1/ADC12_IN9/TIM3_CH4)
SWITCH_OUT1: D1.C, D2.C, D3.C, D4.C, D5.C, D6.C, U1.33 (PB12/SPI2_NSS)
SWITCH_OUT2: D7.C, D8.C, D9.C, D10.C, D11.C, D12.C, U1.37 (PC6)
SWITCH_OUT3: D13.C, D14.C, D15.C, D16.C, D17.C, D18.C, U1.36 (PB15/SPI2_MOSI/TIM1_CH3N)
VOLTAGEGAIN: JP4.7, U1.14 (PA0/ADC12_IN0/TIM2_CH1_ETR)

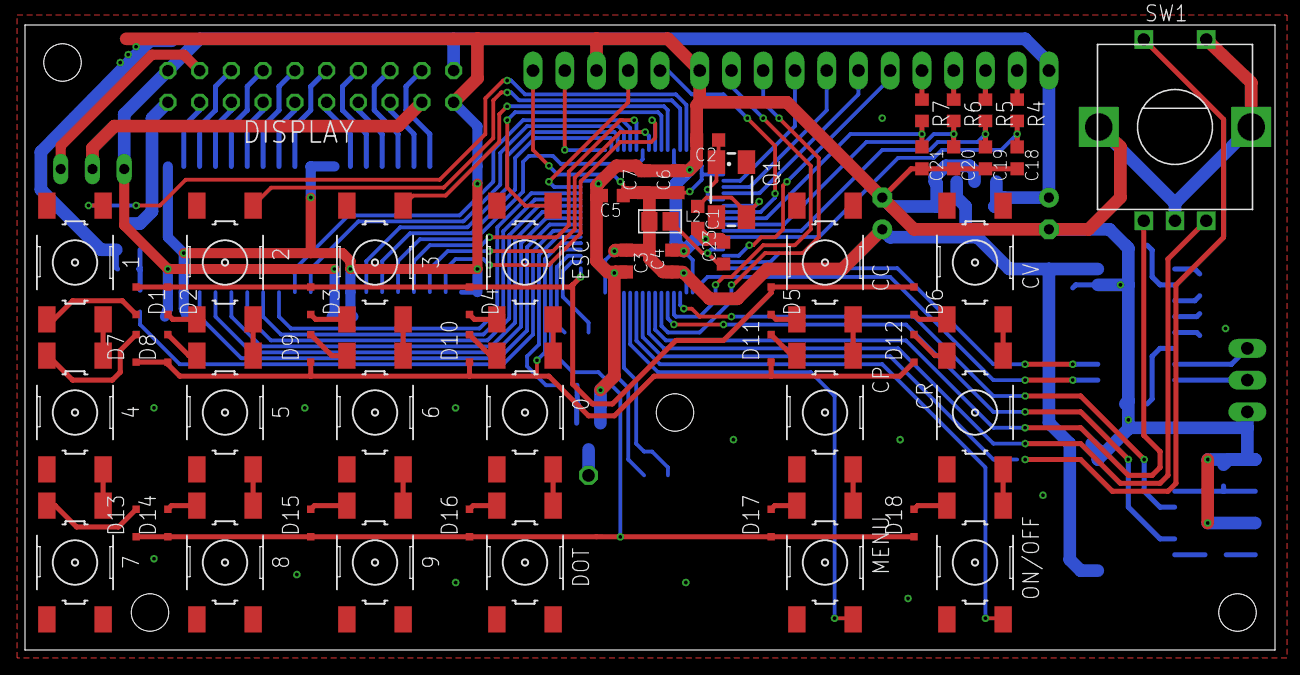
[picture p21: board digitalBoardV1_1.brd from above]

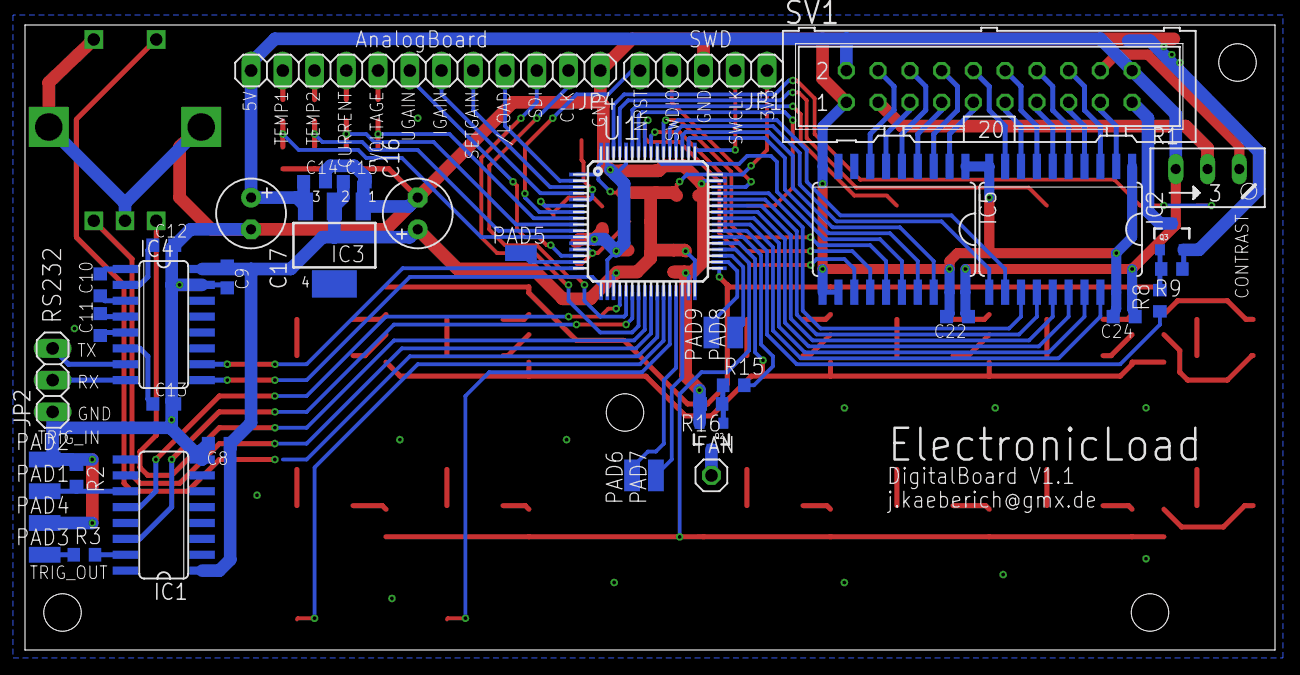
[picture p22: board digitalBoardV1_1.brd from below]

Board: 2 copper layers, 100.0 x 50.0 mm, 96 parts (41 on the bottom side), 121 nets.
