jankae/electronicload/software/eclipse/electronicLoad/src/waveforms.c

#include "waveforms.h"

static const uint16_t wave_SineLookup[1025] = { 0, 101, 201, 302, 402, 503, 603,
        704, 804, 905, 1005, 1106, 1206, 1307, 1407, 1508, 1608, 1709, 1809,
        1910, 2010, 2111, 2211, 2312, 2412, 2513, 2613, 2714, 2814, 2914, 3015,
        3115, 3216, 3316, 3416, 3517, 3617, 3718, 3818, 3918, 4019, 4119, 4219,
        4320, 4420, 4520, 4621, 4721, 4821, 4921, 5022, 5122, 5222, 5322, 5422,
        5523, 5623, 5723, 5823, 5923, 6023, 6123, 6223, 6324, 6424, 6524, 6624,
        6724, 6824, 6924, 7024, 7123, 7223, 7323, 7423, 7523, 7623, 7723, 7823,
        7922, 8022, 8122, 8222, 8321, 8421, 8521, 8620, 8720, 8820, 8919, 9019,
        9118, 9218, 9318, 9417, 9517, 9616, 9715, 9815, 9914, 10014, 10113,
        10212, 10312, 10411, 10510, 10609, 10708, 10808, 10907, 11006, 11105,
        11204, 11303, 11402, 11501, 11600, 11699, 11798, 11897, 11996, 12094,
        12193, 12292, 12391, 12489, 12588, 12687, 12785, 12884, 12982, 13081,
        13179, 13278, 13376, 13475, 13573, 13671, 13770, 13868, 13966, 14064,
        14163, 14261, 14359, 14457, 14555, 14653, 14751, 14849, 14947, 15045,
        15142, 15240, 15338, 15436, 15533, 15631, 15729, 15826, 15924, 16021,
        16119, 16216, 16313, 16411, 16508, 16605, 16703, 16800, 16897, 16994,
        17091, 17188, 17285, 17382, 17479, 17576, 17673, 17769, 17866, 17963,
        18060, 18156, 18253, 18349, 18446, 18542, 18639, 18735, 18831, 18928,
        19024, 19120, 19216, 19312, 19408, 19504, 19600, 19696, 19792, 19888,
        19984, 20079, 20175, 20271, 20366, 20462, 20557, 20653, 20748, 20843,
        20939, 21034, 21129, 21224, 21319, 21414, 21509, 21604, 21699, 21794,
        21889, 21983, 22078, 22173, 22267, 22362, 22456, 22551, 22645, 22739,
        22834, 22928, 23022, 23116, 23210, 23304, 23398, 23492, 23586, 23679,
        23773, 23867, 23960, 24054, 24147, 24241, 24334, 24428, 24521, 24614,
        24707, 24800, 24893, 24986, 25079, 25172, 25265, 25358, 25450, 25543,
        25635, 25728, 25820, 25913, 26005, 26097, 26189, 26281, 26374, 26466,
        26557, 26649, 26741, 26833, 26925, 27016, 27108, 27199, 27291, 27382,
        27473, 27565, 27656, 27747, 27838, 27929, 28020, 28111, 28201, 28292,
        28383, 28473, 28564, 28654, 28745, 28835, 28925, 29015, 29106, 29196,
        29286, 29375, 29465, 29555, 29645, 29734, 29824, 29913, 30003, 30092,
        30181, 30271, 30360, 30449, 30538, 30627, 30716, 30804, 30893, 30982,
        31070, 31159, 31247, 31335, 31424, 31512, 31600, 31688, 31776, 31864,
        31952, 32039, 32127, 32215, 32302, 32390, 32477, 32564, 32651, 32738,
        32826, 32912, 32999, 33086, 33173, 33260, 33346, 33433, 33519, 33605,
        33692, 33778, 33864, 33950, 34036, 34122, 34208, 34293, 34379, 34465,
        34550, 34635, 34721, 34806, 34891, 34976, 35061, 35146, 35231, 35315,
        35400, 35485, 35569, 35654, 35738, 35822, 35906, 35990, 36074, 36158,
        36242, 36326, 36409, 36493, 36576, 36660, 36743, 36826, 36909, 36992,
        37075, 37158, 37241, 37324, 37406, 37489, 37571, 37653, 37736, 37818,
        37900, 37982, 38064, 38145, 38227, 38309, 38390, 38472, 38553, 38634,
        38715, 38797, 38877, 38958, 39039, 39120, 39200, 39281, 39361, 39442,
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

static const char waveform_Names[5][9] = { "SINE", "SAW", "SQUARE", "TRIANGLE",
        "REV SAW" };
static const char *waveformItems[6] = { waveform_Names[0], waveform_Names[1],
        waveform_Names[2], waveform_Names[3], waveform_Names[4], NULL };

static const char waveSetParamNames[4][11] = { "CURRENT", "VOLTAGE",
        "RESISTANCE", "POWER" };
static const char *paramItems[5] = { waveSetParamNames[0], waveSetParamNames[1],
        waveSetParamNames[2], waveSetParamNames[3], NULL };

static uint32_t *waveSetParamPointers[4] = { &load.current, &load.voltage,
        &load.resistance, &load.power };

static container_t c;
static dropdown_t dWave, dParam;
static entry_t eMin, eMax, eAmplitude, eOffset, ePeriod, eFreq;
static label_t lWave, lParam, lMin, lMax, lAmplitude, lOffset, lPeriod, lFreq;
static checkbox_t bOn;

static uint32_t minPeriod = 1, maxPeriod = 500000;
static uint32_t minFreq = 2, maxFreq = 1000000;

void waveform_Init(void) {
    waveform.amplitude = 1000;
    waveform.form = WAVE_SINE;
    waveform.switchedOn = 0;
    waveform.offset = 1000;
    waveform_AmplitudeOffsetChanged();
    waveform.param = &load.current;
    waveform.paramNum = 0;
    waveform.period = 1000;
    waveform_PeriodChanged();

    /* create GUI elements */
    label_createWithText(&lWave, "Wave:", FONT_MEDIUM);
    label_createWithText(&lParam, "Param:", FONT_MEDIUM);
    label_createWithText(&lMin, "Min:", FONT_MEDIUM);
    label_createWithText(&lMax, "Max:", FONT_MEDIUM);
    label_createWithText(&lAmplitude, "Amplitude:", FONT_MEDIUM);
    label_createWithText(&lOffset, "Offset:", FONT_MEDIUM);
    label_createWithText(&lPeriod, "Period:", FONT_MEDIUM);
    label_createWithText(&lFreq, "Frequency:", FONT_MEDIUM);

    checkbox_create(&bOn, &waveform.switchedOn, NULL);

    dropdown_create(&dWave, waveformItems, &waveform.form, FONT_MEDIUM, 0,
            waveform_WaveChanged);
    dropdown_create(&dParam, paramItems, &waveform.paramNum, FONT_MEDIUM, 0,
            waveform_ParamChanged);

    entry_create(&eMin, &waveform.min, NULL, NULL, FONT_MEDIUM, 4, UNIT_CURRENT,
            waveform_MinMaxChanged);
    entry_create(&eMax, &waveform.max, NULL, NULL, FONT_MEDIUM, 4, UNIT_CURRENT,
            waveform_MinMaxChanged);
    entry_create(&eAmplitude, &waveform.amplitude, NULL, NULL, FONT_MEDIUM, 4,
            UNIT_CURRENT, waveform_AmplitudeOffsetChanged);
    entry_create(&eOffset, &waveform.offset, NULL, NULL, FONT_MEDIUM, 4,
            UNIT_CURRENT, waveform_AmplitudeOffsetChanged);
    entry_create(&ePeriod, &waveform.period, &maxPeriod, &minPeriod,
            FONT_MEDIUM, 4, UNIT_TIME, waveform_PeriodChanged);
    entry_create(&eFreq, &waveform.frequency, &maxFreq, &minFreq, FONT_MEDIUM,
            4, UNIT_FREQ, waveform_FrequencyChanged);

    container_create(&c, 128, 55);

    container_attach(&c, (widget_t *) &lWave, 0, 2);
    container_attach(&c, (widget_t *) &lParam, 0, 14);
    container_attach(&c, (widget_t *) &lMin, 0, 26);
    container_attach(&c, (widget_t *) &lMax, 0, 38);
    container_attach(&c, (widget_t *) &lAmplitude, 0, 50);
    container_attach(&c, (widget_t *) &lOffset, 0, 62);
    container_attach(&c, (widget_t *) &lPeriod, 0, 74);
    container_attach(&c, (widget_t *) &lFreq, 0, 86);

    container_attach(&c, (widget_t *) &bOn, 36, 0);
    container_attach(&c, (widget_t *) &dWave, 48, 0);
    container_attach(&c, (widget_t *) &dParam, 36, 12);
    container_attach(&c, (widget_t *) &eMin, 60, 24);
    container_attach(&c, (widget_t *) &eMax, 60, 36);
    container_attach(&c, (widget_t *) &eAmplitude, 60, 48);
    container_attach(&c, (widget_t *) &eOffset, 60, 60);
    container_attach(&c, (widget_t *) &ePeriod, 60, 72);
    container_attach(&c, (widget_t *) &eFreq, 60, 84);
}

widget_t* waveform_getWidget(void) {
    return (widget_t*) &c;
}

void waveform_WaveChanged(void) {

}

void waveform_ParamChanged(void) {
    /* change unit of waveform entries */
    eMin.unit = waveform.paramNum;
    eMax.unit = waveform.paramNum;
    eAmplitude.unit = waveform.paramNum;
    eOffset.unit = waveform.paramNum;
    waveform.param = waveSetParamPointers[waveform.paramNum];
}

void waveform_MinMaxChanged(void) {
    /* calculate offset and amplitude from min/max */
    waveform.offset = (waveform.min + waveform.max) / 2;
    waveform.amplitude = waveform.max - waveform.offset;
}

void waveform_AmplitudeOffsetChanged(void) {
    /* calculate min/max from amplitude/offset */
    waveform.min = waveform.offset - waveform.amplitude;
    if (waveform.min < 0) {
        waveform.min = 0;
    }
    waveform.max = waveform.offset + waveform.amplitude;
}

void waveform_PeriodChanged(void) {
    /* calculate frequency based on period */
    waveform.frequency = 1000000UL / waveform.period;
}

void waveform_FrequencyChanged(void) {
    /* calculate period based on frequency */
    waveform.period = 1000000UL / waveform.frequency;
    waveform_PeriodChanged();
}

void waveform_Update(void) {
    static uint32_t phaseAcc;
    phaseAcc += (UINT32_MAX / waveform.period);
    waveform.phase = phaseAcc >> 16;

    if (!waveform.switchedOn)
        return;
    if (waveform.param) {
        *(waveform.param) = waveform_GetValue(waveform.phase);
    }
}

int32_t waveform_GetValue(uint16_t wavetime) {
    int32_t value;
    switch (waveform.form) {
    case WAVE_SQUARE:
        if (wavetime < 32768)
            value = waveform.amplitude;
        else
            value = -waveform.amplitude;
        break;
    case WAVE_SAW:
        value = -waveform.amplitude
                + ((int64_t) wavetime * waveform.amplitude * 2) / 65536;
        break;
    case WAVE_TRIANGLE:
        if (wavetime >= 32768)
            wavetime = 65535 - wavetime;
        value = -waveform.amplitude
                + ((int64_t) wavetime * waveform.amplitude * 2) / 32768;
        break;
    case WAVE_SINE:
        value = ((int64_t) waveform_Sine(wavetime) * waveform.amplitude)
                / 65536;
        break;
    case WAVE_REV_SAW:
        value = waveform.amplitude
                - ((int64_t) wavetime * waveform.amplitude * 2) / 65536;
        break;
    }
    value += waveform.offset;
    return value;
}

int32_t waveform_Sine(uint16_t arg) {
    int8_t sign;
    if (arg >= 49152) {
        sign = -1;
        arg = 65535 - arg;
    } else if (arg >= 32768) {
        sign = -1;
        arg = arg - 32768;
    } else if (arg >= 16384) {
        sign = 1;
        arg = 32767 - arg;
    } else {
        sign = 1;
    }
    int32_t valueLow = wave_SineLookup[arg / 16];
    int32_t valueHigh = wave_SineLookup[arg / 16 + 1];
    arg %= 16;
    int32_t retvalue = valueLow * (16 - arg) + valueHigh * arg;
    retvalue /= 16;
    return retvalue * sign;
}
