jankae/electronicload/software/eclipse/electronicLoad/src/main.h

#ifndef MAIN_H_
#define MAIN_H_

#include <screen.h>
#include <stdio.h>
#include <stdlib.h>

#include "timer.h"
#include "loadFunctions.h"
#include "extTrigger.h"
#include "menu.h"
#include "uart.h"
#include "statistics.h"
#include "communication.h"
#include "characteristic.h"
#include "settings.h"
#include "multimeter.h"
#include "selftest.h"
#include "test.h"
#include "errors.h"
#include "arbitrary.h"
#include "mainMenu.h"

#endif
