jankae/electronicload/software/eclipse/electronicLoad/src/displayRoutines.h

#ifndef DISPLAYROUTINES_H_
#define DISPLAYROUTINES_H_

#include "display.h"
#include "string.h"
#include "currentSink.h"

typedef enum {PIXEL_OFF, PIXEL_ON} PixelState_t;

struct {
	uint8_t buffer[1024];

	// buffer for the two lines of the default screen
	char defScreen[2][21];
} display;

/*
 * clears the entire dispaly
 */
void display_Clear(void);

/*
 * sets or clears a specific pixel in the display data buffer
 * (no data is actual transmitted to the display, only the *internal*
 * buffer is modified)
 */
void display_SetPixel(uint8_t x, uint8_t y, PixelState_t s);

void display_SetByte(uint8_t x, uint8_t page, uint8_t b);

/*
 * transfers a character into the display buffer by copying the whole bytes
 * (fast but limited to 8 lines in y direction)
 * 0<=x<=115
 * 0<=y<=6
 */
void display_FastChar12x16(uint8_t x, uint8_t ypage, char c);

/*
 * transfers a character into the display buffer by copying the whole bytes
 * (fast but limited to 8 lines in y direction)
 * 0<=x<=121
 * 0<=y<=7
 */
void display_FastChar6x8(uint8_t x, uint8_t ypage, char c);

void display_FastString12x16(char *src, uint8_t x, uint8_t ypage);
void display_FastString6x8(char *src, uint8_t x, uint8_t ypage);

void display_UpdateDefaultScreen(void);

#endif
