jankae/electronicload/software/eclipse/electronicLoad/src/GUI/gui.h

#ifndef GUI_GUI_H_
#define GUI_GUI_H_

#include "button.h"
#include "container.h"
#include "dropdown.h"
#include "entry.h"
#include "label.h"
#include "notebook.h"
#include "message.h"
#include "checkbox.h"
#include "valueLabel.h"

#endif
