jankae/electronicload/software/eclipse/electronicLoad/src/GUI/button.c

#include "button.h"

void button_create(button_t *button, const char *name, font_t font, uint8_t minWidth, void *cb) {
    /* initialize common widget values */
    widget_init((widget_t*) button);
    /* set widget functions */
    button->base.func.draw = button_draw;
    button->base.func.input = button_input;
    /* set name and callback */
    uint8_t i = 0;
    while (*name && i < BUTTON_MAX_NAME) {
        button->name[i++] = *name++;
    }
    button->name[i] = 0;
    button->callback = cb;
    button->font = font;

    /* calculate size based on the font */
    button->base.size.y = fontSize[font].height + 4;
    button->base.size.x = fontSize[font].width * i + 4;

    if(minWidth > button->base.size.x)
        button->base.size.x = minWidth;

    /* calculate font start position */
    button->fontStart.y = 2;
    button->fontStart.x = (button->base.size.x
            - fontSize[button->font].width * i - 1) / 2;
}

GUIResult_t button_draw(widget_t *w, coords_t offset) {
    button_t *b = (button_t*) w;
    /* calculate corners */
    coords_t upperLeft = offset;
    upperLeft.x += b->base.position.x;
    upperLeft.y += b->base.position.y;
    coords_t lowerRight = upperLeft;
    lowerRight.x += b->base.size.x - 1;
    lowerRight.y += b->base.size.y - 1;
    /* draw outline */
    screen_VerticalLine(upperLeft.x, upperLeft.y + 1, b->base.size.y - 2);
    screen_VerticalLine(lowerRight.x - 1, upperLeft.y + 1, b->base.size.y - 2);
    screen_VerticalLine(lowerRight.x, upperLeft.y + 1, b->base.size.y - 2);
    screen_HorizontalLine(upperLeft.x + 1, upperLeft.y, b->base.size.x - 2);
    screen_HorizontalLine(upperLeft.x + 1, lowerRight.y - 1,
            b->base.size.x - 2);
    screen_HorizontalLine(upperLeft.x + 1, lowerRight.y, b->base.size.x - 2);
    if (b->name) {
        screen_String(b->name, b->font, upperLeft.x + b->fontStart.x,
                upperLeft.y + b->fontStart.y);
    }
    if (b->base.flags.selected) {
        /* invert button area */
        screen_FullRectangle(upperLeft.x + 1, upperLeft.y + 1,
                lowerRight.x - 2, lowerRight.y - 2, PIXEL_INVERT);
    }
    return GUI_OK;
}

GUISignal_t button_input(widget_t *w, GUISignal_t signal) {
    button_t *b = (button_t*) w;
    if ((signal.clicked & HAL_BUTTON_ENTER)
            || (signal.clicked & HAL_BUTTON_ENCODER)) {
        /* call button clicked callback */
        if (b->callback) {
            b->callback();
        }
        /* clear this signal */
        signal.clicked &= ~(HAL_BUTTON_ENTER | HAL_BUTTON_ENCODER);
    }
    return signal;
}
