jankae/electronicload/software/eclipse/electronicLoad/src/GUI/button.h

#ifndef GUI_BUTTON_H_
#define GUI_BUTTON_H_

#include "widget.h"
#include "screen.h"
#include "font.h"

#define BUTTON_MAX_NAME         16

typedef struct {
    widget_t base;
    void (*callback)(void);
    char name[BUTTON_MAX_NAME + 1];
    font_t font;
    coords_t fontStart;
} button_t;

void button_create(button_t *button, const char *name, font_t font, uint8_t minWidth, void *cb);
GUIResult_t button_draw(widget_t *w, coords_t offset);
GUISignal_t button_input(widget_t *w, GUISignal_t signal);

#endif
