jankae/electronicload/(commit log)

2016-02-01 initial commit hardware
    [analogBoardV1.brd, analogBoardV1.sch, digitalBoardV1_1.brd, digitalBoardV1_1.sch, powerSupplyV1.brd, powerSupplyV1.sch]
2016-02-01 added calibration read and write routines for flash values
2016-02-01 save calibration values after calibration process
2016-02-01 added default calibration values
2016-02-01 changed frontpanel button from enum to bitmask (allows detection of multiple buttons pressed at the same time)
2016-02-02 moved MS_TO_TICKS macro from main to timer
2016-02-02 doxygen documentation + using timer1 as systemclock
2016-02-02 added wait time for ADC settling
2016-02-02 added power off functionality
2016-02-03 added alternative button functions (arrow buttons)
2016-02-03 encoder movement handling in default screen
2016-02-03 added calibration menu to main menu
2016-02-07 display RST pin change due to botched up solder job
2016-02-07 clear timer interrupt bit
2016-02-07 hardware system interrupt handlers
2016-02-08 hal display bug fixes: - disable Jtag tu use GPIO pins
    [display.c, display.h]
2016-02-08 bugfix: made timer.ms volatile
    [timer.h]
2016-02-08 bugfix: changed setPixel function according to new buffer layout
    [screen.c]
2016-02-08 changed ADC channels to correct values, added macros for DAC GPIOs
    [currentSink.c, currentSink.h]
2016-02-08 added encoder sensitivity setting. Also changed DAC update frequency to 2kHz
2016-02-08 various bugfixes in main menu
    [menu.c]
2016-02-08 added temperature to default screen. Also fixed bug in power calculation
    [screen.c]
2016-02-11 changed external input trigger mode from interrupt to polling
2016-02-11 corrected ADC channel order
    [currentSink.h]
2016-02-11 added event handling in the load update interrupt
2016-02-11 fixed: stay in main menu after leaving sub menu
    [menu.c]
2016-02-12 bugfix: don't allow dots for integers without fixed point
    [menu.c]
2016-02-25 omitted hardware trimmer calibration
2016-02-25 included calibration reading at startup
2016-02-25 added fan control + overtemperature shutdown
2016-02-25 bugfix temperature scale
2016-02-25 bugfix number of displayed digits
    [menu.c]
2016-02-28 various bugfixes + adjusted calibration process
    [calibration.c]
2016-03-03 uart hal added (+ some test ouputs in main)
2016-03-03 fixed powerOn/powerOff events
2016-03-04 added basic debouncing for frontpanel switches
2016-03-08 removed calibration section in linker script, instead working with FLASH adresses directly (calibration won't be lost during programming anymore)
    [calibration.c]
2016-03-08 uart recieve functionality
2016-03-08 combining load_update and hal_frontpanelupdate to free timer 4
2016-03-08 renamed string to stringFunctions (issues with string.h from standard library)
    [screen.h, stringFunctions.c, stringFunctions.h]
2016-03-08 basic uart commands
2016-03-08 added a few uart commands
2016-03-08 terminate uart retrieve string
2016-03-21 hal_frontPanelUpdate even when calibration is active
2016-03-21 progress bar during ADC sampling
2016-03-21 new analogBoard
    [analogBoardV1_2.brd, analogBoardV1_2.sch]
2016-05-06 switch off waveforms in constant modes and vice-versa
2016-05-07 waveform phase can be used as event trigger + minor bugfixes
    [events.c, events.h, loadFunctions.c, waveforms.c, waveforms.h]
2016-05-09 encoder sensitivity is now changeable
2016-05-09 bugfix: wrong current values during high-to-low ramp
    [characteristic.h]
2016-05-09 measurement aborted on crossing threshold voltage
2016-05-10 sending measurement results via uart
2016-07-10 bugfix: swapped buttons
2016-07-10 baudrate settable via uart_init
2016-07-10 added busy flag indicating uart transmission
2016-07-10 actual change the uart baudrate
2016-07-17 added BOM
    [BOM.ods]
2016-07-22 calibration changed: voltage can be specified (within limits)
2016-07-22 menu-settable current/power/voltage/resistance limits
2016-09-08 dedicated board for analog control (OPs, DAC, ADC)
    [analogControlBoardV1.brd, analogControlBoardV1.sch]
2016-09-09 analog version update
    [analogBoardV1_5.brd, analogBoardV1_5.sch, analogControlBoardV1.brd, analogControlBoardV1.sch]
2016-09-09 cleaned up schematics + markings an analogBoard
    [analogBoardV1_5.brd, analogBoardV1_5.sch, analogControlBoardV1.sch]
2016-09-12 a lot of changes:
    - multimeter integration (UT61E) for automatic calibration
    - added soft buttons
    - input dialog adapted to accept different units
2016-09-14 BOM for new analog board design
    [BOM_analogBoardV1_5.csv, BOM_analogControlBoardV1_1.csv]
2016-09-14 glue logic firmware analog board
2016-09-14 added internal bandgap voltage to ADC channels
2016-09-14 hardware calibration procedure added
2016-09-16 different limits in low/high power mode
2016-09-16 adjustments for different fixed integer algorithmik
    [characteristic.c, statistics.c, waveforms.c]
2016-09-16 removed unused current limit define
2016-09-17 mostly calibration stuff
2016-09-17 more calibration stuff
2016-09-17 calibration reduced to two point calibration
2016-09-17 default calibration added
2016-09-18 automatic calibration nearly completed
2016-09-18 resistance calibration added
2016-09-18 bugfix: wrong usage of calibration points
    [calibration.c]
2016-09-18 bugfix: got rid of extra space in case dot=0
    [stringFunctions.c]
2016-09-18 included temperature in main screen
2016-09-20 bugfix: int64_t cast moved
    [waveforms.c]
2016-09-20 SPI timing fixes
    - additional delay for AVR added
    - optional Assembler routines for DAC and ADC
    [currentSink.c, currentSink.h]
2016-09-20 some tests for buttons and the ascii font (+easter egg)
2016-09-22 analog board fixes
    - enabled interrupts
    - moved ADC evaluation from interrupt into main (was interfering with
    SPI timing)
    [adc.c, adc.h, main.c, spi.h]
2016-09-22 various bugfixes in communication with analog board
    - additional delay between SPI bytes (allow time for interrupt in AVR)
    - read rails now reading from correct ADC channels
    [currentSink.c]
2016-09-22 more tests, mainly for testing communication with analog board
2016-09-24 set ports directly in SPI interrupts -> less jitter on the port delay
    [main.c, spi.c]
2016-09-24 bugfix: too many chars if using prefix + displaying dot
    [stringFunctions.c]
2016-09-24 test functions for ADC and DAC
2016-09-24 ADC averaging
2016-09-24 default calibration adjusted to new resistor value
2016-09-24 relaxed timing on AVR (might work faster but this eliminated wrong data)
    [currentSink.c]
2016-09-25 ADC + DAC calls corrected
    [loadFunctions.c]
2016-09-25 give AVR more time to start (more accurate selftest voltages)
2016-09-26 number of maximum ADC samples increased
2016-09-26 some bugfixes in calibration routine + split of calibration struct
    [calibration.c, calibration.h, loadFunctions.c, test.c]
2016-09-29 more precise communication
    Don't change amount of communication with analog board during
    calibration -> less deviation due to digital feedtrough
2016-10-07 oscillation detection using ADC
    [currentSink.c, currentSink.h]
2016-10-07 bugfix: disable IO control during some tests
    [loadFunctions.c, loadFunctions.h, test.c]
2016-10-08 set SPI MOSI low when not in use (got rid of strange miscommunications)
2016-10-09 bugfix: write CAL_INDICATOR instead hard-coded 0x01
    [calibration.c]
2016-10-09 various bugfixes for analog/digital control modes
    [loadFunctions.c, settings.c]
2016-10-11 ADC unstable function extended
    [currentSink.c, currentSink.h]
2016-10-11 ADC averaging and checking for unstable condition
    [loadFunctions.c, loadFunctions.h, menu.c]
2016-10-11 hardware calibration updated
2016-10-11 automatic turn off if error occurs (TODO: reset errors in menu)
    [loadFunctions.c, loadFunctions.h, settings.c, settings.h]
2016-10-12 moved error handling into dedicated file
    [errors.c, errors.h, loadFunctions.c, loadFunctions.h, menu.c]
2016-10-12 debugging: error detection and displaying
    [errors.c, errors.h, loadFunctions.h, main.c, main.h, screen.c, screen.h, settings.c]
2016-10-12 use screen_text in calibration messages
2016-10-12 turn all mosfets off if error present
    [loadFunctions.c]
2016-10-22 Fan controlled from digital board
2016-10-22 additional errors plus longer delay on error condition
    [errors.c, errors.h]
2016-10-22 higher fan threshold
2016-10-24 increased maximum allowed current while switched off
2016-10-24 calibration splitted into multiple small calibration routines
2016-10-24 case/switch instead of ifs
2016-10-24 bugfix waveform phase calculation
    [waveforms.c]
2016-10-25 missing files to previous commit
    [arbitrary.c, arbitrary.h]
2016-10-29 error duration reduced again
    [errors.h]
2016-10-29 voltage calibration completed
2017-01-29 label drawing + selectable fixed
    [label.c]
2017-01-29 invertRectangle -> fullRectangle (either on/off or invert)
    [button.c, entry.c, screen.c, screen.h]
2017-01-29 bugfix PIXEL_ON -> PIXEL_INVERT
    [button.c]
2017-01-29 automatic button size based on font
2017-01-30 extensive changes
    - GUI message box
    - common settings for high and low power mode
    - settings menu using new GUI
2017-01-30 Calibration menu moved
2017-02-06 new waveform: reverse saw
    [waveforms.c, waveforms.h]
2017-02-07 'turn off on error' setting added
    [label.h, settings.c]
2017-02-07 Few bugfixes + beginning of event menu
    [dropdown.c, events.c, events.h, main.c, stringFunctions.c, stringFunctions.h, units.c, units.h]
2017-04-25 New Board version
    [analogControlBoardV1_3.brd, analogControlBoardV1_3.sch]
