jankae/electronicload/(notices)

Notices in the files:
parts and their libraries:
xmaker: Licensing: CC v3.0 Attribution-Share Alike
http://creativecommons.org/licenses/by-sa/3.0
